Charading/SM65/(list of files, drawings)

Other design files:
testing/hall_matrix/freerouting.dsn
testing/hall_matrix/temp-freerouting.dsn
