Charading/SM65/pcbs/SM65.kicad_pcb

## KiCad design pcbs/SM65.kicad_pcb (2025-11-28)

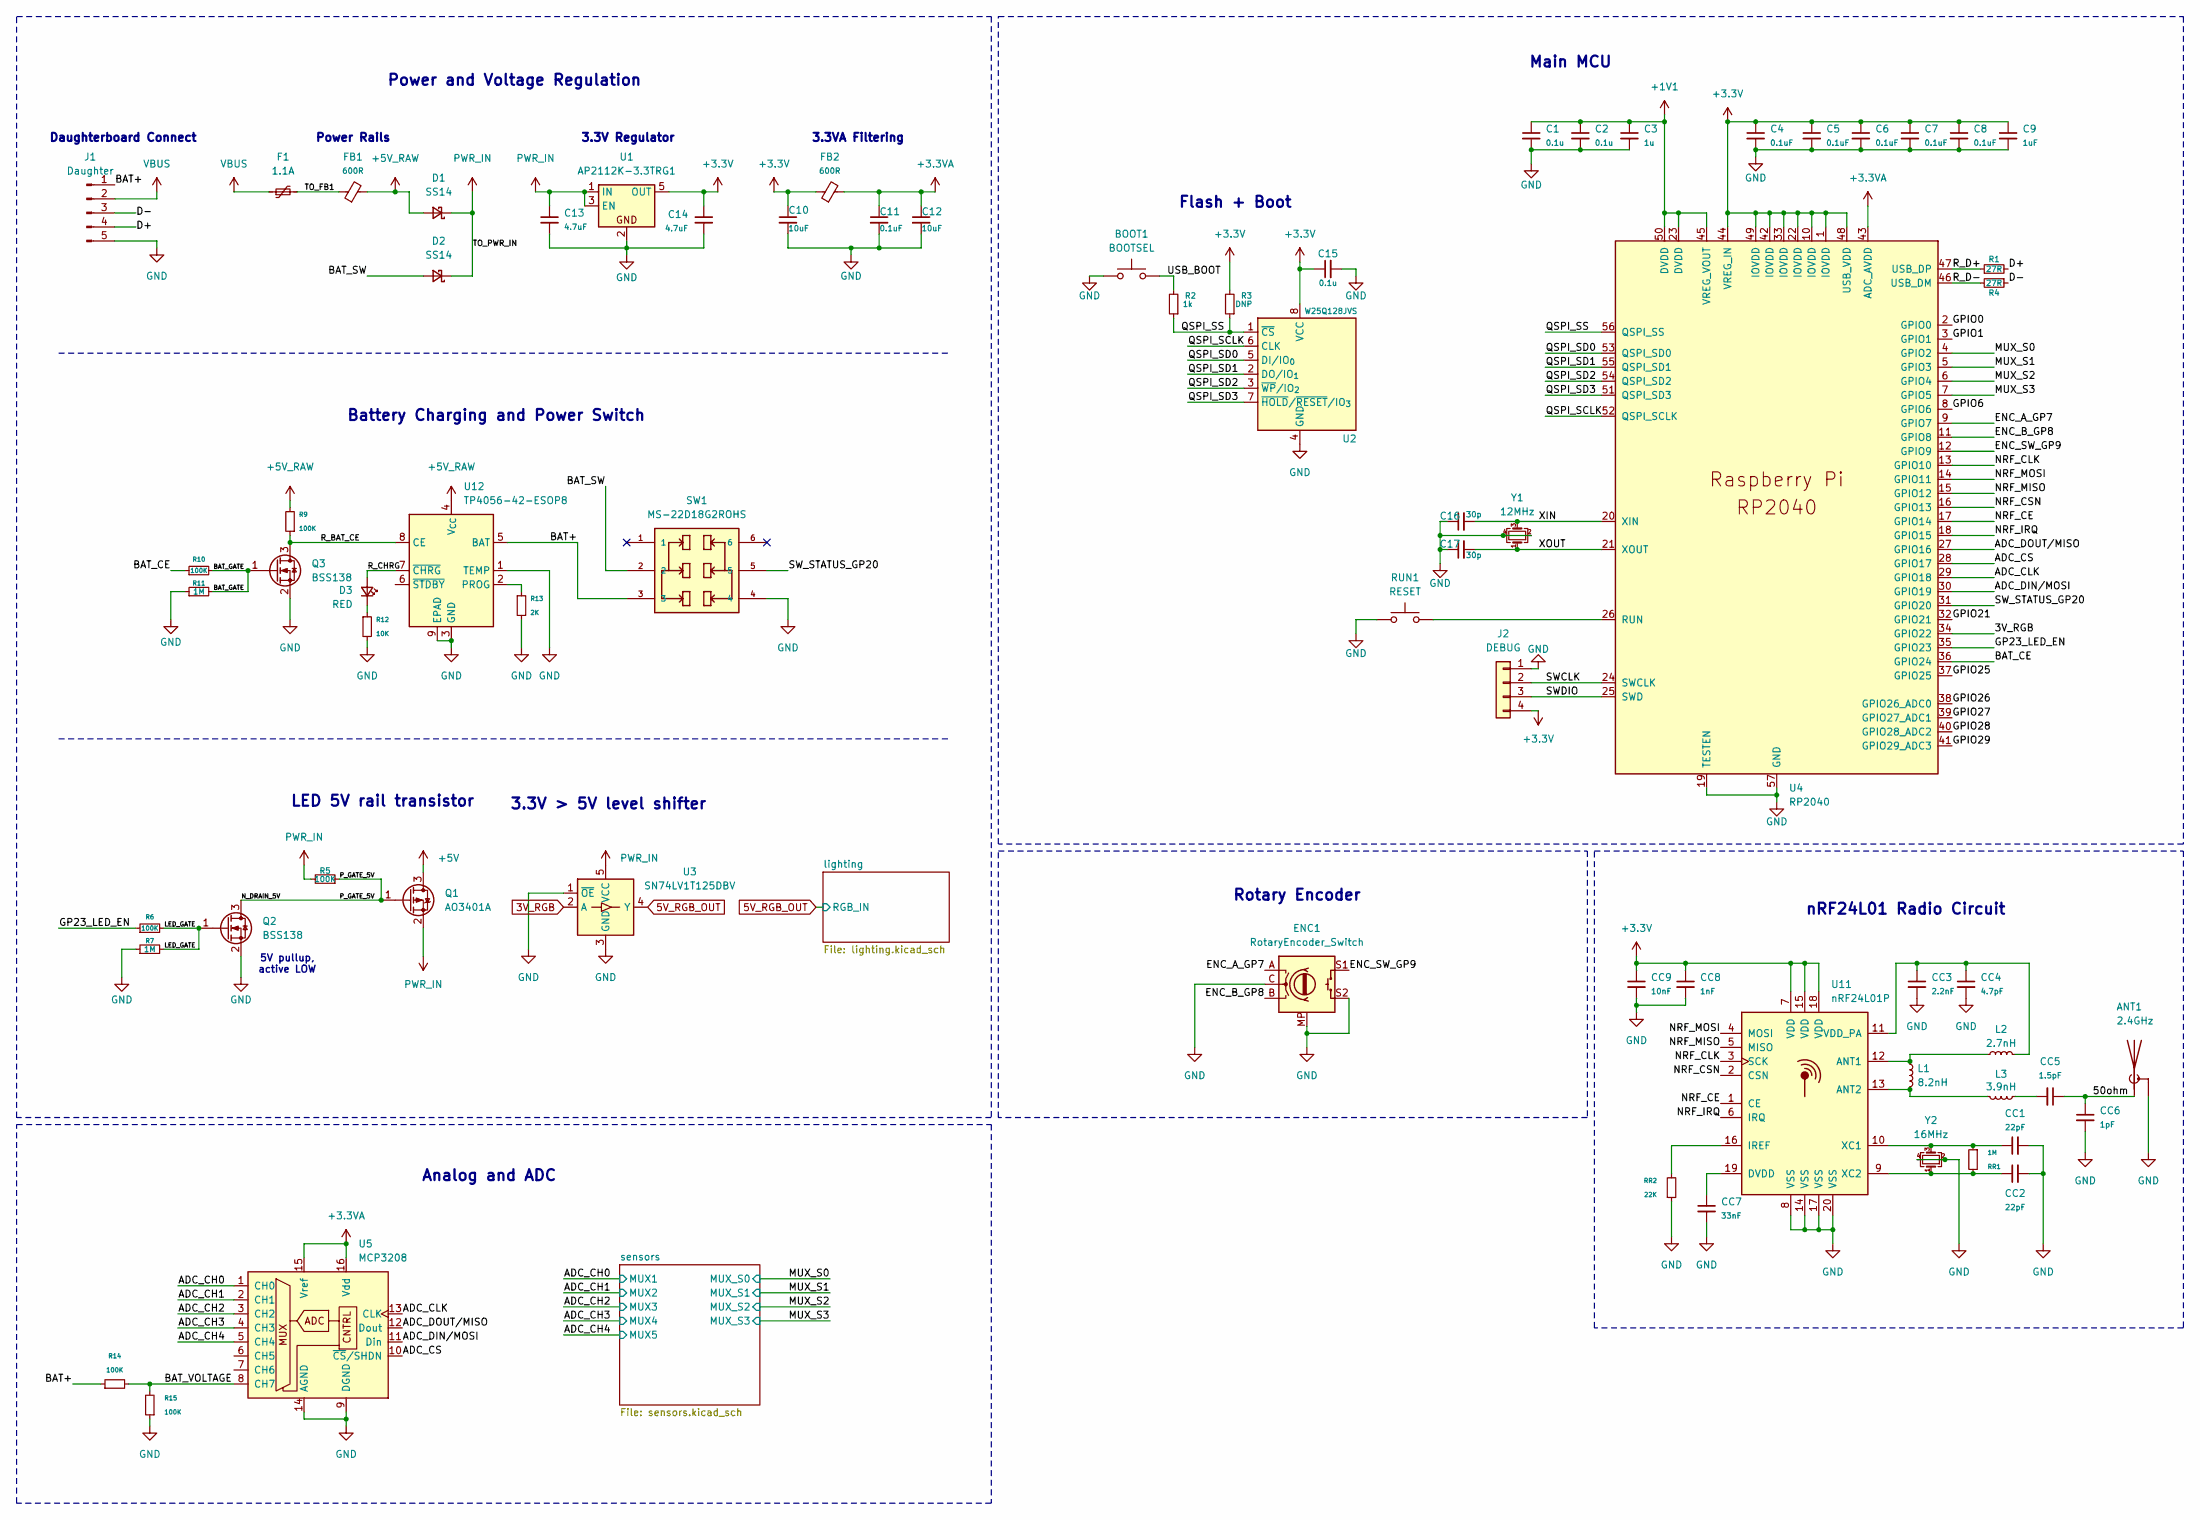
[picture p1: schematic SM65.kicad_sch]

Parts:
ANT1: 2.4GHz; MIFA_2.4GHz_Antenna
BOOT1: BOOTSEL; SW_SPST_EVQP2_MiddlePushTravel_H2.5mm
C1, C2: 0.1u; C_0402
C3: 1u; C_0402
C4, C5, C6, C7, C8: 0.1uF; C_0402
C9: 1uF; C_0402
C10, C12: 10uF; C_0603
C11: 0.1uF; C_0603
C13, C14: 4.7uF; C_0603
C15: 0.1u; C_0603
C16, C17: 30p; C_0402
CC1, CC2: 22pF; C_0402
CC3: 2.2nF; C_0402
CC4: 4.7pF; C_0402
CC5: 1.5pF; C_0402
CC6: 1pF; C_0402
CC7: 33nF; C_0402
CC8: 1nF; C_0402
CC9: 10nF; C_0402
D1, D2: SS14; D_SMA
D3: RED; LED_0402_1005Metric
ENC1: RotaryEncoder_Switch; RotaryEncoder_MX_EC11_CircularMountingHoles
F1: 1.1A; Fuse_0603_1608Metric
FB1, FB2: 600R; Ferrite_0603_1608Metric
J1: Daughter; JST_GH_BM05B-GHS-TBT_1x05-1MP_P1.25mm_Vertical
J2: DEBUG; PinHeader_1x04_P1.27mm_Vertical; Part Number 1-0401FBV0T
L1: 8.2nH; R_0402
L2: 2.7nH; R_0402
L3: 3.9nH; R_0402
Q1: AO3401A; SOT-23
Q2, Q3: BSS138; SOT-23
R1, R4: 27R; R_0603_1608Metric_Pad0.98x0.95mm_HandSolder
R2: 1k; R_0603
R3: DNP; R_0603
R5, R6, R9, R10, R14, R15: 100K; R_0603
R7, R11: 1M; R_0603
R12: 10K; R_0402
R13: 2K; R_0603
RR1: 1M; R_0402
RR2: 22K; R_0402
RUN1: RESET; SW_SPST_EVQP2_MiddlePushTravel_H2.5mm
SW1: MS-22D18G2ROHS; MS-22D18_SMD
U1: AP2112K-3.3TRG1; SOT-23-5
U2: W25Q128JVS; SOIC-8_5.3x5.3mm_P1.27mm
U3: SN74LV1T125DBV; SOT-23-5
U4: RP2040; QFN-56-1EP_7x7mm_P0.4mm_EP3.2x3.2mm
U5: MCP3208; SOIC-16_3.9x9.9mm_P1.27mm
U11: nRF24L01P; QFN-20-1EP_4x4mm_P0.5mm_EP2.5x2.5mm
U12: TP4056-42-ESOP8; SOIC-8-1EP_3.9x4.9mm_P1.27mm_EP2.41x3.3mm
Y1: 12MHz; Crystal_SMD_3225-4Pin_3.2x2.5mm
Y2: 16MHz; Crystal_SMD_3225-4Pin_3.2x2.5mm

Connections:
3V_RGB: U3.2 (A), U4.34 (GPIO22)
5V_RGB_OUT: U3.4 (Y); also elsewhere on the board
+1V1: C1.1, C2.1, C3.1, U4.23 (DVDD), U4.45 (VREG_VOUT), U4.50 (DVDD)
+3.3V: C4.1, C5.1, C6.1, C7.1, C8.1, C9.1, C10.1, C14.1, C15.1, CC8.1, CC9.1, FB2.1, J2.4, R3.2, U1.5 (OUT), U2.8 (VCC), U4.1 (IOVDD), U4.10 (IOVDD), U4.22 (IOVDD), U4.33 (IOVDD), U4.42 (IOVDD), U4.44 (VREG_IN), U4.48 (USB_VDD), U4.49 (IOVDD), U11.7 (VDD), U11.15 (VDD), U11.18 (VDD); also elsewhere on the board
+3.3VA: C11.1, C12.1, FB2.2, U4.43 (ADC_AVDD), U5.15 (Vref), U5.16 (Vdd)
+5V: Q1.3 (D); also elsewhere on the board
+5V_RAW: D1.2 (A), FB1.2, R9.2, U12.4 (V_{CC})
/50ohm: ANT1.1 (A), CC5.1, CC6.1
/ADC_CH0: U5.1 (CH0); also elsewhere on the board
/ADC_CH1: U5.2 (CH1); also elsewhere on the board
/ADC_CH2: U5.3 (CH2); also elsewhere on the board
/ADC_CH3: U5.4 (CH3); also elsewhere on the board
/ADC_CH4: U5.5 (CH4); also elsewhere on the board
/ADC_CLK: U4.29 (GPIO18), U5.13 (CLK)
/ADC_CS: U4.28 (GPIO17), U5.10 (~CS/SHDN)
/ADC_DIN/MOSI: U4.30 (GPIO19), U5.11 (Din)
/ADC_DOUT/MISO: U4.27 (GPIO16), U5.12 (Dout)
/BAT+: J1.1, R14.1, SW1.3, U12.5 (BAT)
/BAT_CE: R10.1, U4.36 (GPIO24)
/BAT_GATE: Q3.1 (G), R10.2, R11.2
/BAT_SW: D2.2 (A), SW1.2
/BAT_VOLTAGE: R14.2, R15.2, U5.8 (CH7)
/D+: J1.4, R1.2
/D-: J1.3, R4.1
/ENC_A_GP7: ENC1.A, U4.9 (GPIO7)
/ENC_B_GP8: ENC1.B, U4.11 (GPIO8)
/ENC_SW_GP9: ENC1.S1, U4.12 (GPIO9)
/GP23_LED_EN: R6.1, U4.35 (GPIO23)
/GPIO0: U4.2 (GPIO0)
/GPIO1: U4.3 (GPIO1)
/GPIO6: U4.8 (GPIO6)
/GPIO21: U4.32 (GPIO21)
/GPIO25: U4.37 (GPIO25)
/GPIO26: U4.38 (GPIO26_ADC0)
/GPIO27: U4.39 (GPIO27_ADC1)
/GPIO28: U4.40 (GPIO28_ADC2)
/GPIO29: U4.41 (GPIO29_ADC3)
/LED_GATE: Q2.1 (G), R6.2, R7.2
/MUX_S0: U4.4 (GPIO2); also elsewhere on the board
/MUX_S1: U4.5 (GPIO3); also elsewhere on the board
/MUX_S2: U4.6 (GPIO4); also elsewhere on the board
/MUX_S3: U4.7 (GPIO5); also elsewhere on the board
/NRF_CE: U4.17 (GPIO14), U11.1 (CE)
/NRF_CLK: U4.13 (GPIO10), U11.3 (SCK)
/NRF_CSN: U4.16 (GPIO13), U11.2 (CSN)
/NRF_IRQ: U4.18 (GPIO15), U11.6 (IRQ)
/NRF_MISO: U4.15 (GPIO12), U11.5 (MISO)
/NRF_MOSI: U4.14 (GPIO11), U11.4 (MOSI)
/N_DRAIN_5V: Q1.1 (G), Q2.3 (D), R5.1
/QSPI_SCLK: U2.6 (CLK), U4.52 (QSPI_SCLK)
/QSPI_SD0: U2.5 (DI/IO_{0}), U4.53 (QSPI_SD0)
/QSPI_SD1: U2.2 (DO/IO_{1}), U4.55 (QSPI_SD1)
/QSPI_SD2: U2.3 (~WP/IO_{2}), U4.54 (QSPI_SD2)
/QSPI_SD3: U2.7 (~HOLD/~RESET/IO_{3}), U4.51 (QSPI_SD3)
/QSPI_SS: R2.1, R3.1, U2.1 (~CS), U4.56 (QSPI_SS)
/R_BAT_CE: Q3.3 (D), R9.1, U12.8 (CE)
/R_CHRG: D3.2 (A), U12.7 (~CHRG)
/R_D+: R1.1, U4.47 (USB_DP)
/R_D-: R4.2, U4.46 (USB_DM)
/SWCLK: J2.2, U4.24 (SWCLK)
/SWDIO: J2.3, U4.25 (SWD)
/SW_STATUS_GP20: SW1.5, U4.31 (GPIO20)
/TO_FB1: F1.2, FB1.1
/USB_BOOT: BOOT1.2, R2.2
/XIN: C16.2, U4.20 (XIN), Y1.3
/XOUT: C17.2, U4.21 (XOUT), Y1.1
GND: ANT1.2 (Shield), BOOT1.1, C1.2, C2.2, C3.2, C4.2, C5.2, C6.2, C7.2, C8.2, C9.2, C10.2, C11.2, C12.2, C13.2, C14.2, C15.2, C16.1, C17.1, CC1.2, CC2.2, CC3.2, CC4.2, CC6.2, CC7.2, CC8.2, CC9.2, ENC1.C, ENC1.MP, ENC1.S2, J1.5, J2.1, Q2.2 (S), Q3.2 (S), R7.1, R11.1, R12.2, R13.2, R15.1, RR2.1, RUN1.1, SW1.4, U1.2, U2.4 (GND), U3.1 (~OE), U3.3 (GND), U4.19 (TESTEN), U4.57 (GND), U5.9 (DGND), U5.14 (AGND), U11.8 (VSS), U11.14 (VSS), U11.17 (VSS), U11.20 (VSS), U12.1 (TEMP), U12.3 (GND), U12.9 (EPAD), Y1.2, Y1.4, Y2.2, Y2.4; also elsewhere on the board
unnamed: CC5.2, L3.1
unnamed: D3.1 (K), R12.1
unnamed: RUN1.2, U4.26 (RUN)
unnamed: L1.1, L2.1, U11.12 (ANT1)
unnamed: L1.2, L3.2, U11.13 (ANT2)
unnamed: CC7.1, U11.19 (DVDD)
unnamed: RR2.2, U11.16 (IREF)
unnamed: CC3.1, CC4.1, L2.2, U11.11 (VDD_PA)
unnamed: CC1.1, RR1.1, U11.10 (XC1), Y2.3
unnamed: CC2.1, RR1.2, U11.9 (XC2), Y2.1
unnamed: R13.1, U12.2 (PROG)
PWR_IN: C13.1, D1.1 (K), D2.1 (K), Q1.2 (S), R5.2, U1.1 (IN), U1.3 (EN), U3.5 (VCC)
VBUS: F1.1, J1.2

Notes on the sheet:
LED 5V rail transistor
3.3V > 5V level shifter
Rotary Encoder
Flash + Boot
5V pullup, active LOW
Battery Charging and Power Switch
Daughterboard Connect
Analog and ADC
3.3V Regulator
nRF24L01 Radio Circuit
Power and Voltage Regulation
3.3VA Filtering
Main MCU
Power Rails

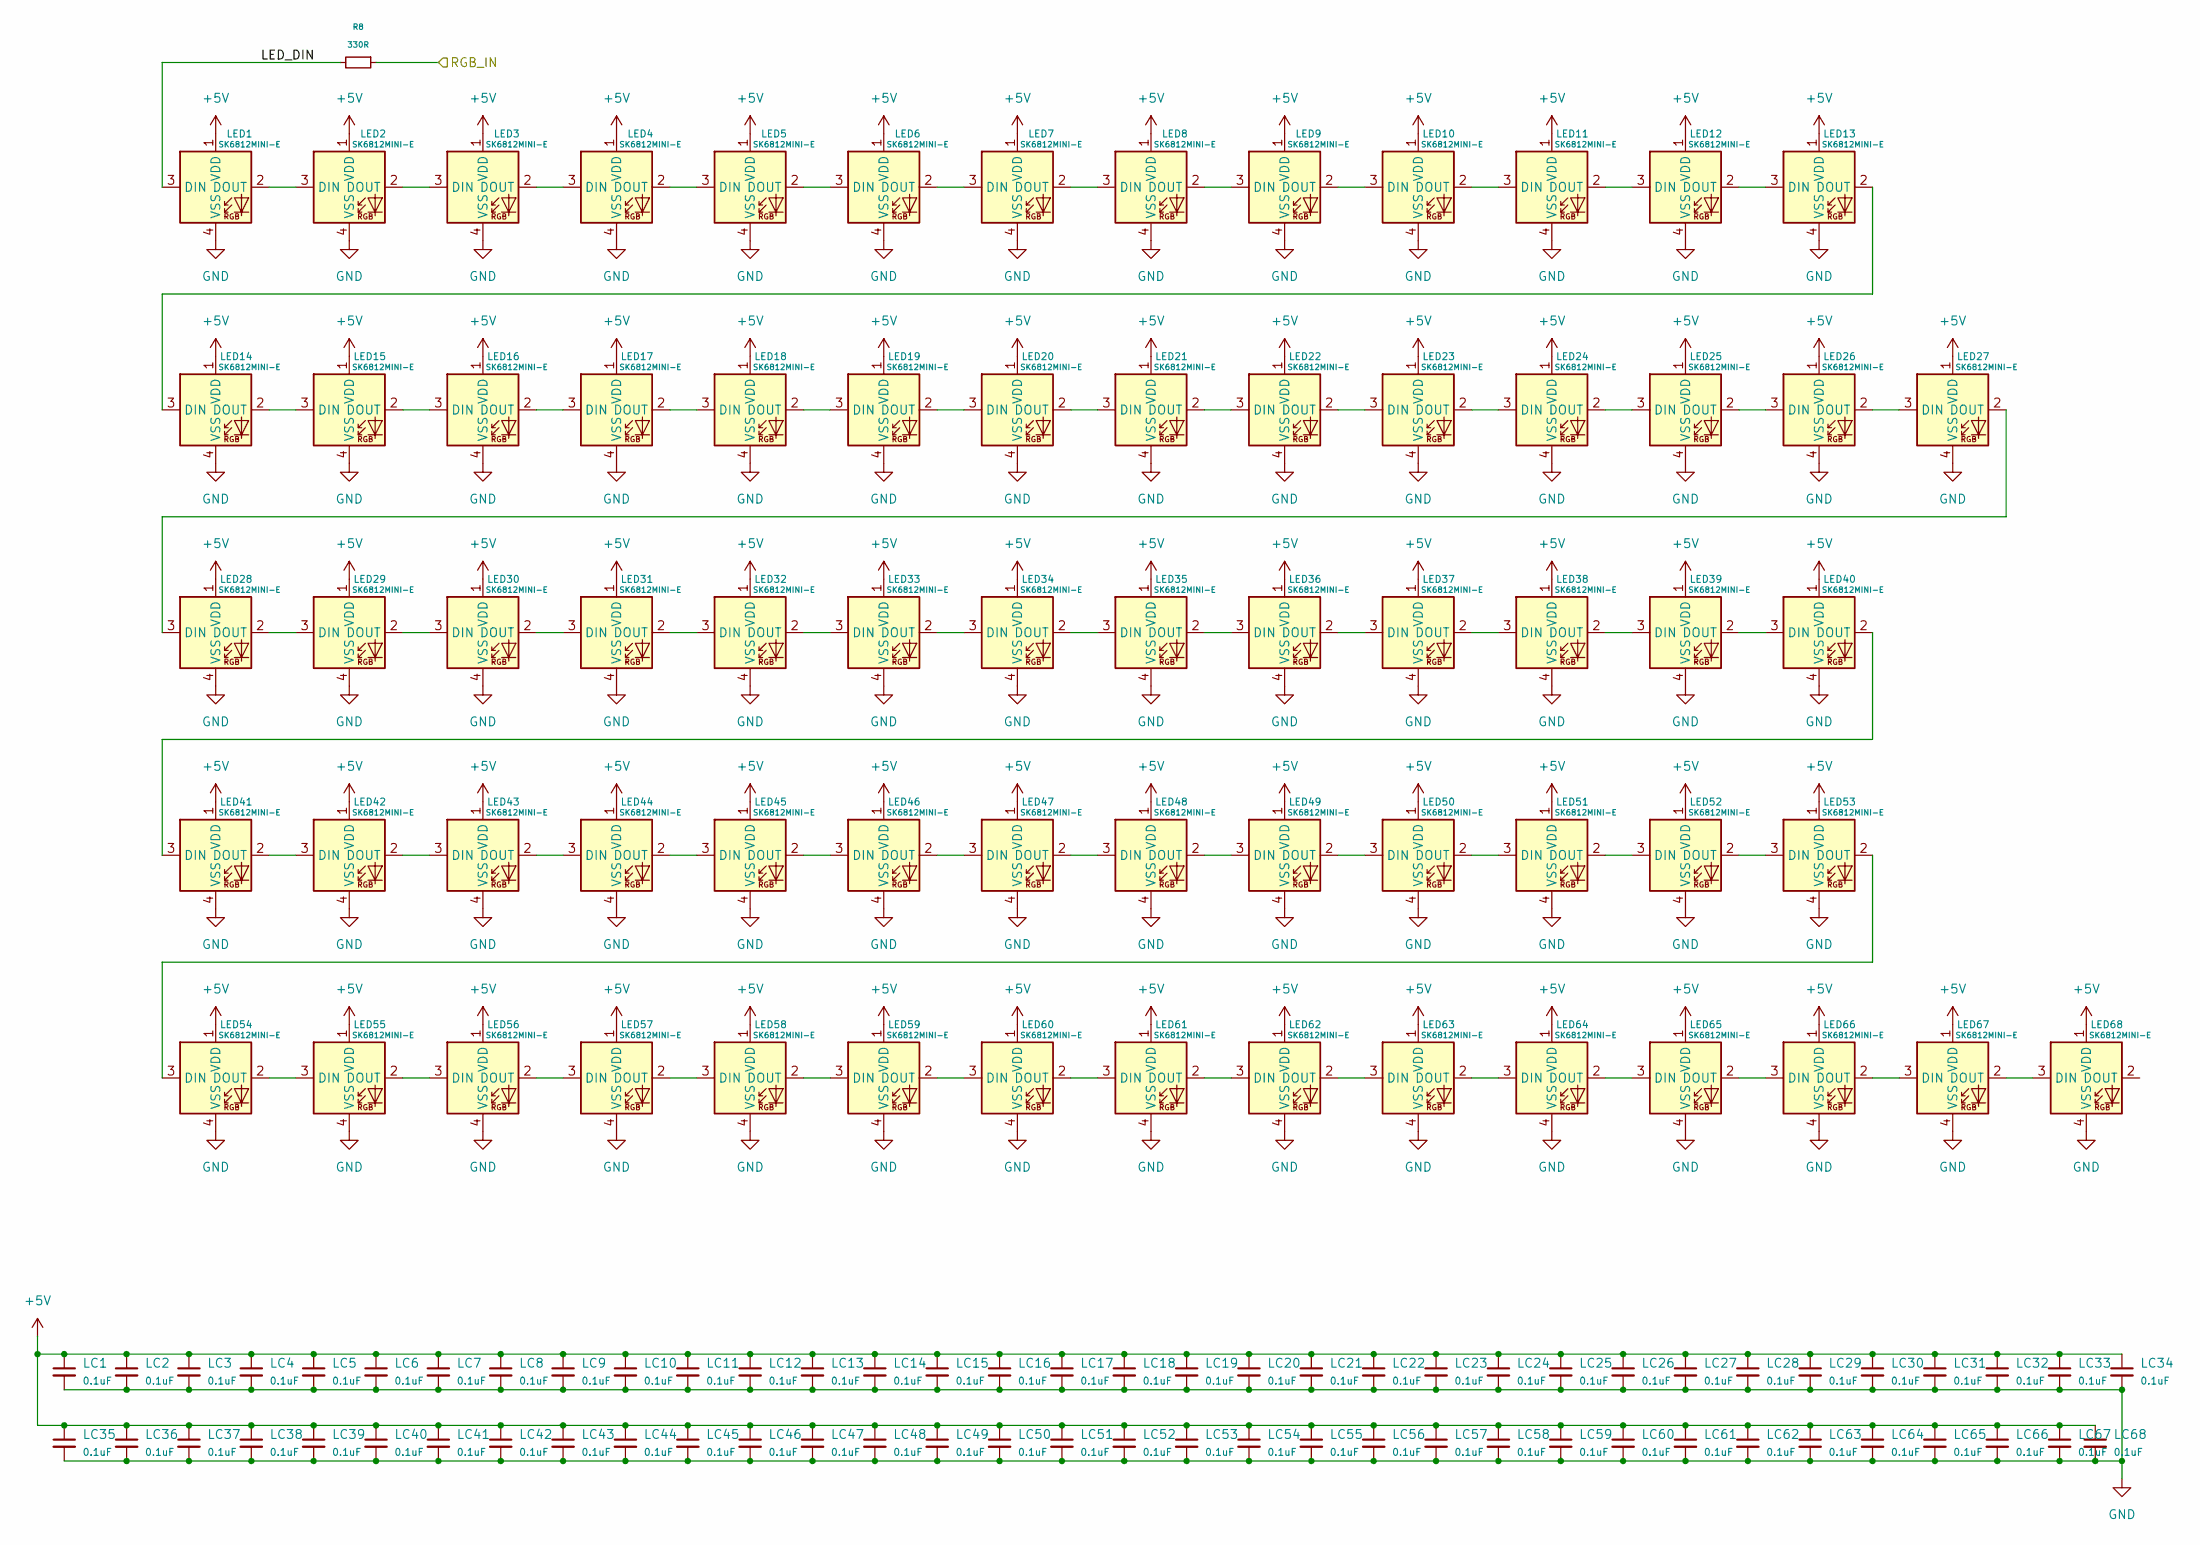
[picture p2: schematic lighting.kicad_sch]

Parts:
LC1, LC2, LC3, LC4, LC5, LC6, LC7, LC8, LC9, LC10, LC11, LC12, LC13, LC14, LC15, LC16, LC17, LC18, LC19, LC20, LC21, LC22, LC23, LC24, LC25, LC26, LC27, LC28, LC29, LC30, LC31, LC32, LC33, LC34, LC35, LC36, LC37, LC38, LC39, LC40, LC41, LC42, LC43, LC44, LC45, LC46, LC47, LC48, LC49, LC50, LC51, LC52, LC53, LC54, LC55, LC56, LC57, LC58, LC59, LC60, LC61, LC62, LC63, LC64, LC65, LC66, LC67, LC68: 0.1uF; C_0402
LED1, LED2, LED3, LED4, LED5, LED6, LED7, LED8, LED9, LED10, LED11, LED12, LED13, LED14, LED15, LED16, LED17, LED18, LED19, LED20, LED21, LED22, LED23, LED24, LED25, LED26, LED27, LED28, LED29, LED30, LED31, LED32, LED33, LED34, LED35, LED36, LED37, LED38, LED39, LED40, LED41, LED42, LED43, LED44, LED45, LED46, LED47, LED48, LED49, LED50, LED51, LED52, LED53, LED54, LED55, LED56, LED57, LED58, LED59, LED60, LED61, LED62, LED63, LED64, LED65, LED66, LED67, LED68: SK6812MINI-E; LED_6028R; LCSC C5149201
R8: 330R; R_0603

Connections:
5V_RGB_OUT: R8.1; also elsewhere on the board
+5V: LC1.1, LC2.1, LC3.1, LC4.1, LC5.1, LC6.1, LC7.1, LC8.1, LC9.1, LC10.1, LC11.1, LC12.1, LC13.1, LC14.1, LC15.1, LC16.1, LC17.1, LC18.1, LC19.1, LC20.1, LC21.1, LC22.1, LC23.1, LC24.1, LC25.1, LC26.1, LC27.1, LC28.1, LC29.1, LC30.1, LC31.1, LC32.1, LC33.1, LC34.1, LC35.1, LC36.1, LC37.1, LC38.1, LC39.1, LC40.1, LC41.1, LC42.1, LC43.1, LC44.1, LC45.1, LC46.1, LC47.1, LC48.1, LC49.1, LC50.1, LC51.1, LC52.1, LC53.1, LC54.1, LC55.1, LC56.1, LC57.1, LC58.1, LC59.1, LC60.1, LC61.1, LC62.1, LC63.1, LC64.1, LC65.1, LC66.1, LC67.1, LC68.1, LED1.1 (VDD), LED2.1 (VDD), LED3.1 (VDD), LED4.1 (VDD), LED5.1 (VDD), LED6.1 (VDD), LED7.1 (VDD), LED8.1 (VDD), LED9.1 (VDD), LED10.1 (VDD), LED11.1 (VDD), LED12.1 (VDD), LED13.1 (VDD), LED14.1 (VDD), LED15.1 (VDD), LED16.1 (VDD), LED17.1 (VDD), LED18.1 (VDD), LED19.1 (VDD), LED20.1 (VDD), LED21.1 (VDD), LED22.1 (VDD), LED23.1 (VDD), LED24.1 (VDD), LED25.1 (VDD), LED26.1 (VDD), LED27.1 (VDD), LED28.1 (VDD), LED29.1 (VDD), LED30.1 (VDD), LED31.1 (VDD), LED32.1 (VDD), LED33.1 (VDD), LED34.1 (VDD), LED35.1 (VDD), LED36.1 (VDD), LED37.1 (VDD), LED38.1 (VDD), LED39.1 (VDD), LED40.1 (VDD), LED41.1 (VDD), LED42.1 (VDD), LED43.1 (VDD), LED44.1 (VDD), LED45.1 (VDD), LED46.1 (VDD), LED47.1 (VDD), LED48.1 (VDD), LED49.1 (VDD), LED50.1 (VDD), LED51.1 (VDD), LED52.1 (VDD), LED53.1 (VDD), LED54.1 (VDD), LED55.1 (VDD), LED56.1 (VDD), LED57.1 (VDD), LED58.1 (VDD), LED59.1 (VDD), LED60.1 (VDD), LED61.1 (VDD), LED62.1 (VDD), LED63.1 (VDD), LED64.1 (VDD), LED65.1 (VDD), LED66.1 (VDD), LED67.1 (VDD), LED68.1 (VDD); also elsewhere on the board
/lighting/LED_DIN: LED1.3 (DIN), R8.2
GND: LC1.2, LC2.2, LC3.2, LC4.2, LC5.2, LC6.2, LC7.2, LC8.2, LC9.2, LC10.2, LC11.2, LC12.2, LC13.2, LC14.2, LC15.2, LC16.2, LC17.2, LC18.2, LC19.2, LC20.2, LC21.2, LC22.2, LC23.2, LC24.2, LC25.2, LC26.2, LC27.2, LC28.2, LC29.2, LC30.2, LC31.2, LC32.2, LC33.2, LC34.2, LC35.2, LC36.2, LC37.2, LC38.2, LC39.2, LC40.2, LC41.2, LC42.2, LC43.2, LC44.2, LC45.2, LC46.2, LC47.2, LC48.2, LC49.2, LC50.2, LC51.2, LC52.2, LC53.2, LC54.2, LC55.2, LC56.2, LC57.2, LC58.2, LC59.2, LC60.2, LC61.2, LC62.2, LC63.2, LC64.2, LC65.2, LC66.2, LC67.2, LC68.2, LED1.4 (VSS), LED2.4 (VSS), LED3.4 (VSS), LED4.4 (VSS), LED5.4 (VSS), LED6.4 (VSS), LED7.4 (VSS), LED8.4 (VSS), LED9.4 (VSS), LED10.4 (VSS), LED11.4 (VSS), LED12.4 (VSS), LED13.4 (VSS), LED14.4 (VSS), LED15.4 (VSS), LED16.4 (VSS), LED17.4 (VSS), LED18.4 (VSS), LED19.4 (VSS), LED20.4 (VSS), LED21.4 (VSS), LED22.4 (VSS), LED23.4 (VSS), LED24.4 (VSS), LED25.4 (VSS), LED26.4 (VSS), LED27.4 (VSS), LED28.4 (VSS), LED29.4 (VSS), LED30.4 (VSS), LED31.4 (VSS), LED32.4 (VSS), LED33.4 (VSS), LED34.4 (VSS), LED35.4 (VSS), LED36.4 (VSS), LED37.4 (VSS), LED38.4 (VSS), LED39.4 (VSS), LED40.4 (VSS), LED41.4 (VSS), LED42.4 (VSS), LED43.4 (VSS), LED44.4 (VSS), LED45.4 (VSS), LED46.4 (VSS), LED47.4 (VSS), LED48.4 (VSS), LED49.4 (VSS), LED50.4 (VSS), LED51.4 (VSS), LED52.4 (VSS), LED53.4 (VSS), LED54.4 (VSS), LED55.4 (VSS), LED56.4 (VSS), LED57.4 (VSS), LED58.4 (VSS), LED59.4 (VSS), LED60.4 (VSS), LED61.4 (VSS), LED62.4 (VSS), LED63.4 (VSS), LED64.4 (VSS), LED65.4 (VSS), LED66.4 (VSS), LED67.4 (VSS), LED68.4 (VSS); also elsewhere on the board
unnamed: LED1.2 (DOUT), LED2.3 (DIN)
unnamed: LED2.2 (DOUT), LED3.3 (DIN)
unnamed: LED3.2 (DOUT), LED4.3 (DIN)
unnamed: LED4.2 (DOUT), LED5.3 (DIN)
unnamed: LED5.2 (DOUT), LED6.3 (DIN)
unnamed: LED6.2 (DOUT), LED7.3 (DIN)
unnamed: LED7.2 (DOUT), LED8.3 (DIN)
unnamed: LED8.2 (DOUT), LED9.3 (DIN)
unnamed: LED9.2 (DOUT), LED10.3 (DIN)
unnamed: LED10.2 (DOUT), LED11.3 (DIN)
unnamed: LED11.2 (DOUT), LED12.3 (DIN)
unnamed: LED12.2 (DOUT), LED13.3 (DIN)
unnamed: LED13.2 (DOUT), LED14.3 (DIN)
unnamed: LED14.2 (DOUT), LED15.3 (DIN)
unnamed: LED15.2 (DOUT), LED16.3 (DIN)
unnamed: LED16.2 (DOUT), LED17.3 (DIN)
unnamed: LED17.2 (DOUT), LED18.3 (DIN)
unnamed: LED18.2 (DOUT), LED19.3 (DIN)
unnamed: LED19.2 (DOUT), LED20.3 (DIN)
unnamed: LED20.2 (DOUT), LED21.3 (DIN)
unnamed: LED21.2 (DOUT), LED22.3 (DIN)
unnamed: LED22.2 (DOUT), LED23.3 (DIN)
unnamed: LED23.2 (DOUT), LED24.3 (DIN)
unnamed: LED24.2 (DOUT), LED25.3 (DIN)
unnamed: LED25.2 (DOUT), LED26.3 (DIN)
unnamed: LED26.2 (DOUT), LED27.3 (DIN)
unnamed: LED27.2 (DOUT), LED28.3 (DIN)
unnamed: LED28.2 (DOUT), LED29.3 (DIN)
unnamed: LED29.2 (DOUT), LED30.3 (DIN)
unnamed: LED30.2 (DOUT), LED31.3 (DIN)
unnamed: LED31.2 (DOUT), LED32.3 (DIN)
unnamed: LED32.2 (DOUT), LED33.3 (DIN)
unnamed: LED33.2 (DOUT), LED34.3 (DIN)
unnamed: LED34.2 (DOUT), LED35.3 (DIN)
unnamed: LED35.2 (DOUT), LED36.3 (DIN)
unnamed: LED36.2 (DOUT), LED37.3 (DIN)
unnamed: LED37.2 (DOUT), LED38.3 (DIN)
unnamed: LED38.2 (DOUT), LED39.3 (DIN)
unnamed: LED39.2 (DOUT), LED40.3 (DIN)
unnamed: LED40.2 (DOUT), LED41.3 (DIN)
unnamed: LED41.2 (DOUT), LED42.3 (DIN)
unnamed: LED42.2 (DOUT), LED43.3 (DIN)
unnamed: LED43.2 (DOUT), LED44.3 (DIN)
unnamed: LED44.2 (DOUT), LED45.3 (DIN)
unnamed: LED45.2 (DOUT), LED46.3 (DIN)
unnamed: LED46.2 (DOUT), LED47.3 (DIN)
unnamed: LED47.2 (DOUT), LED48.3 (DIN)
unnamed: LED48.2 (DOUT), LED49.3 (DIN)
unnamed: LED49.2 (DOUT), LED50.3 (DIN)
unnamed: LED50.2 (DOUT), LED51.3 (DIN)
unnamed: LED51.2 (DOUT), LED52.3 (DIN)
unnamed: LED52.2 (DOUT), LED53.3 (DIN)
unnamed: LED53.2 (DOUT), LED54.3 (DIN)
unnamed: LED54.2 (DOUT), LED55.3 (DIN)
unnamed: LED55.2 (DOUT), LED56.3 (DIN)
unnamed: LED56.2 (DOUT), LED57.3 (DIN)
unnamed: LED57.2 (DOUT), LED58.3 (DIN)
unnamed: LED58.2 (DOUT), LED59.3 (DIN)
unnamed: LED59.2 (DOUT), LED60.3 (DIN)
unnamed: LED60.2 (DOUT), LED61.3 (DIN)
unnamed: LED61.2 (DOUT), LED62.3 (DIN)
unnamed: LED62.2 (DOUT), LED63.3 (DIN)
unnamed: LED63.2 (DOUT), LED64.3 (DIN)
unnamed: LED64.2 (DOUT), LED65.3 (DIN)
unnamed: LED65.2 (DOUT), LED66.3 (DIN)
unnamed: LED66.2 (DOUT), LED67.3 (DIN)
unnamed: LED67.2 (DOUT), LED68.3 (DIN)

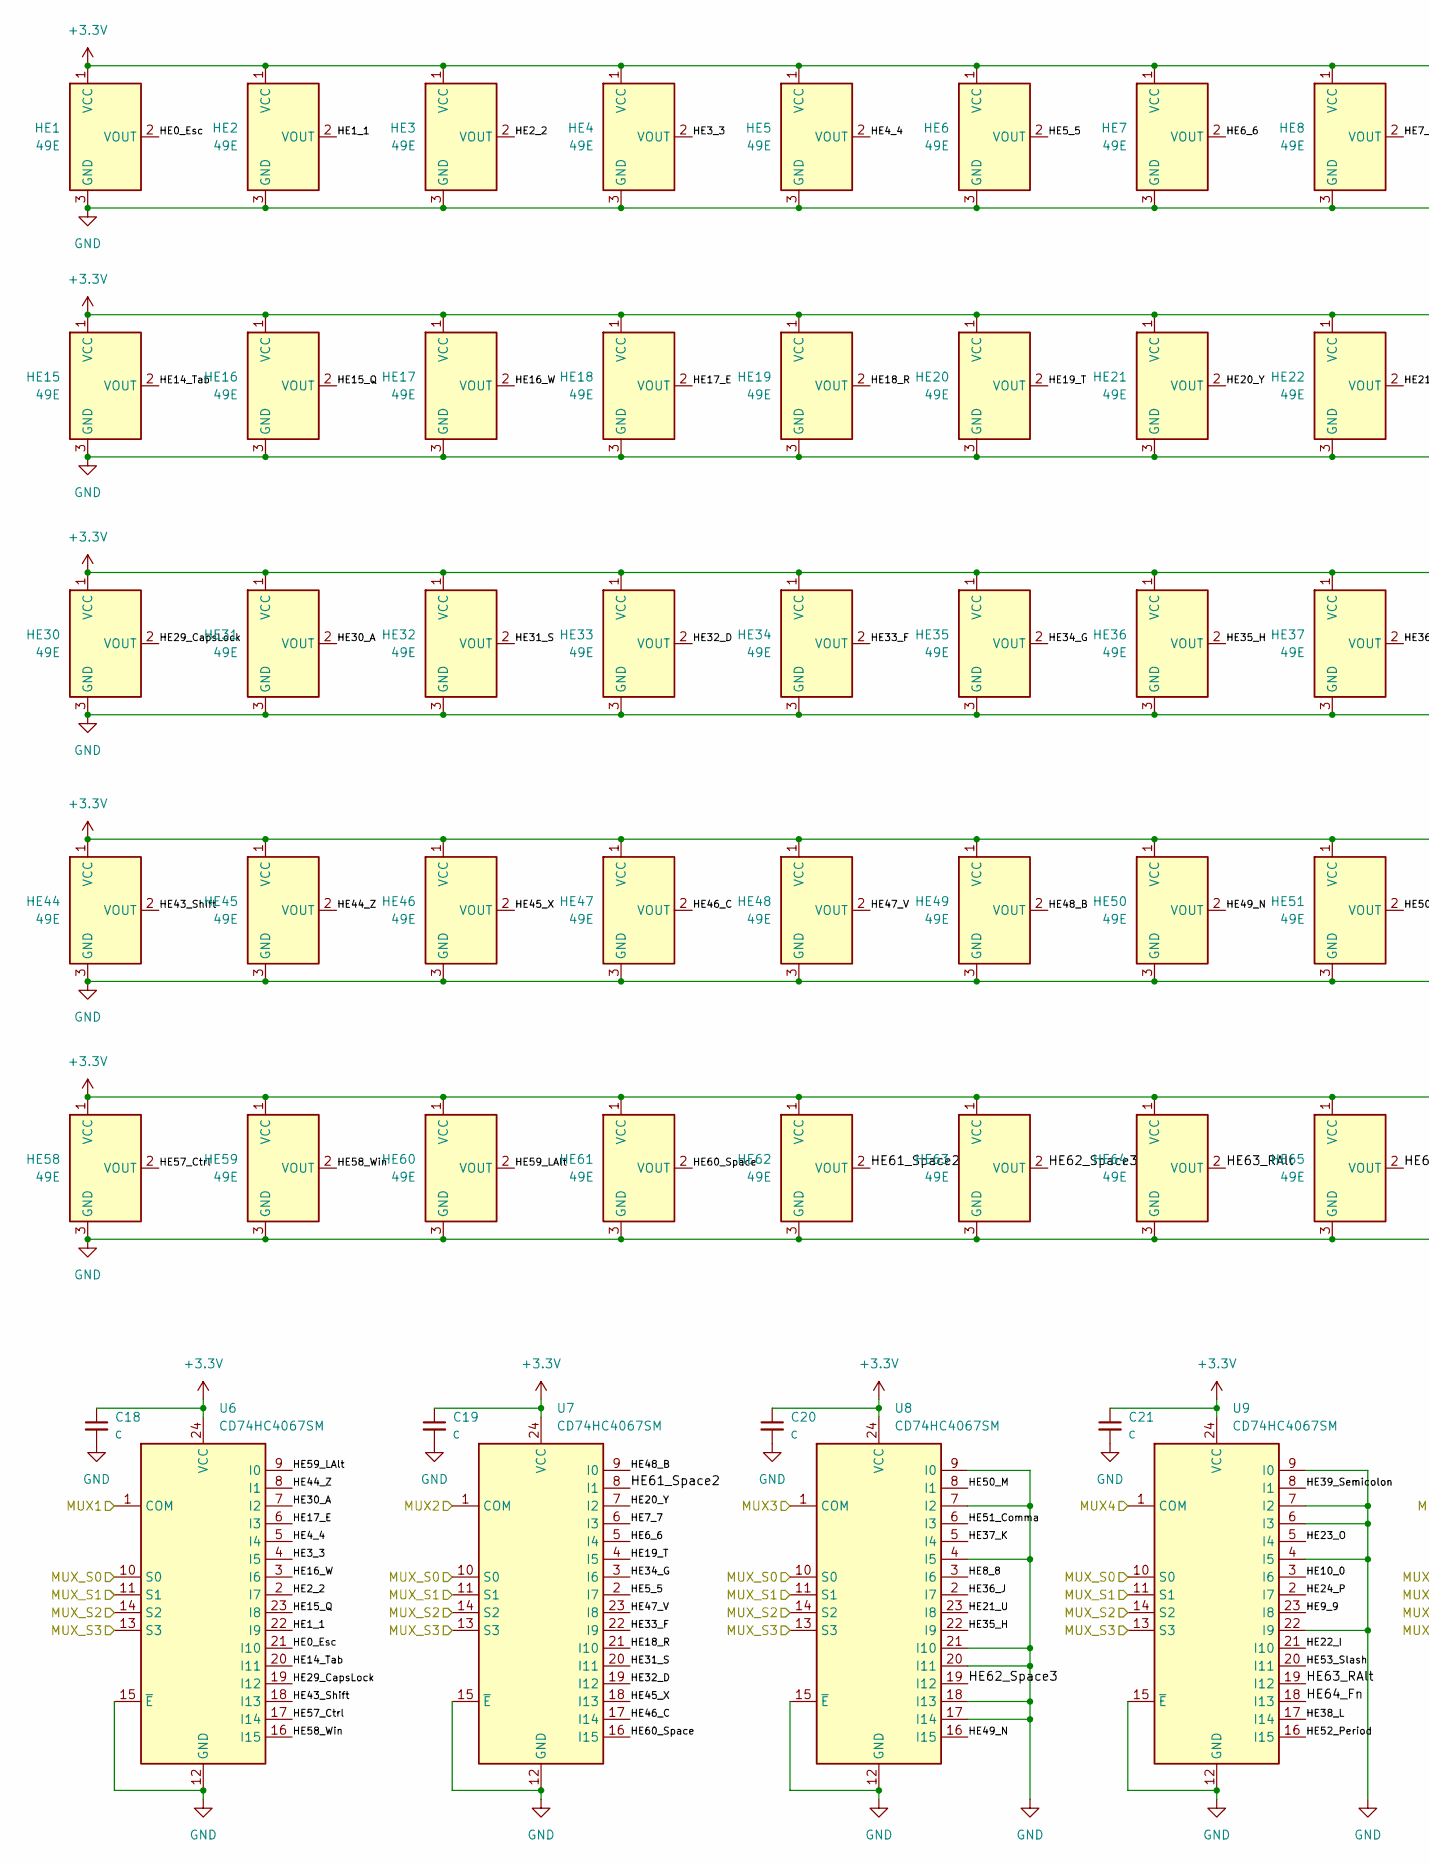
[picture p3: schematic sensors.kicad_sch, part in row 1, column 1]

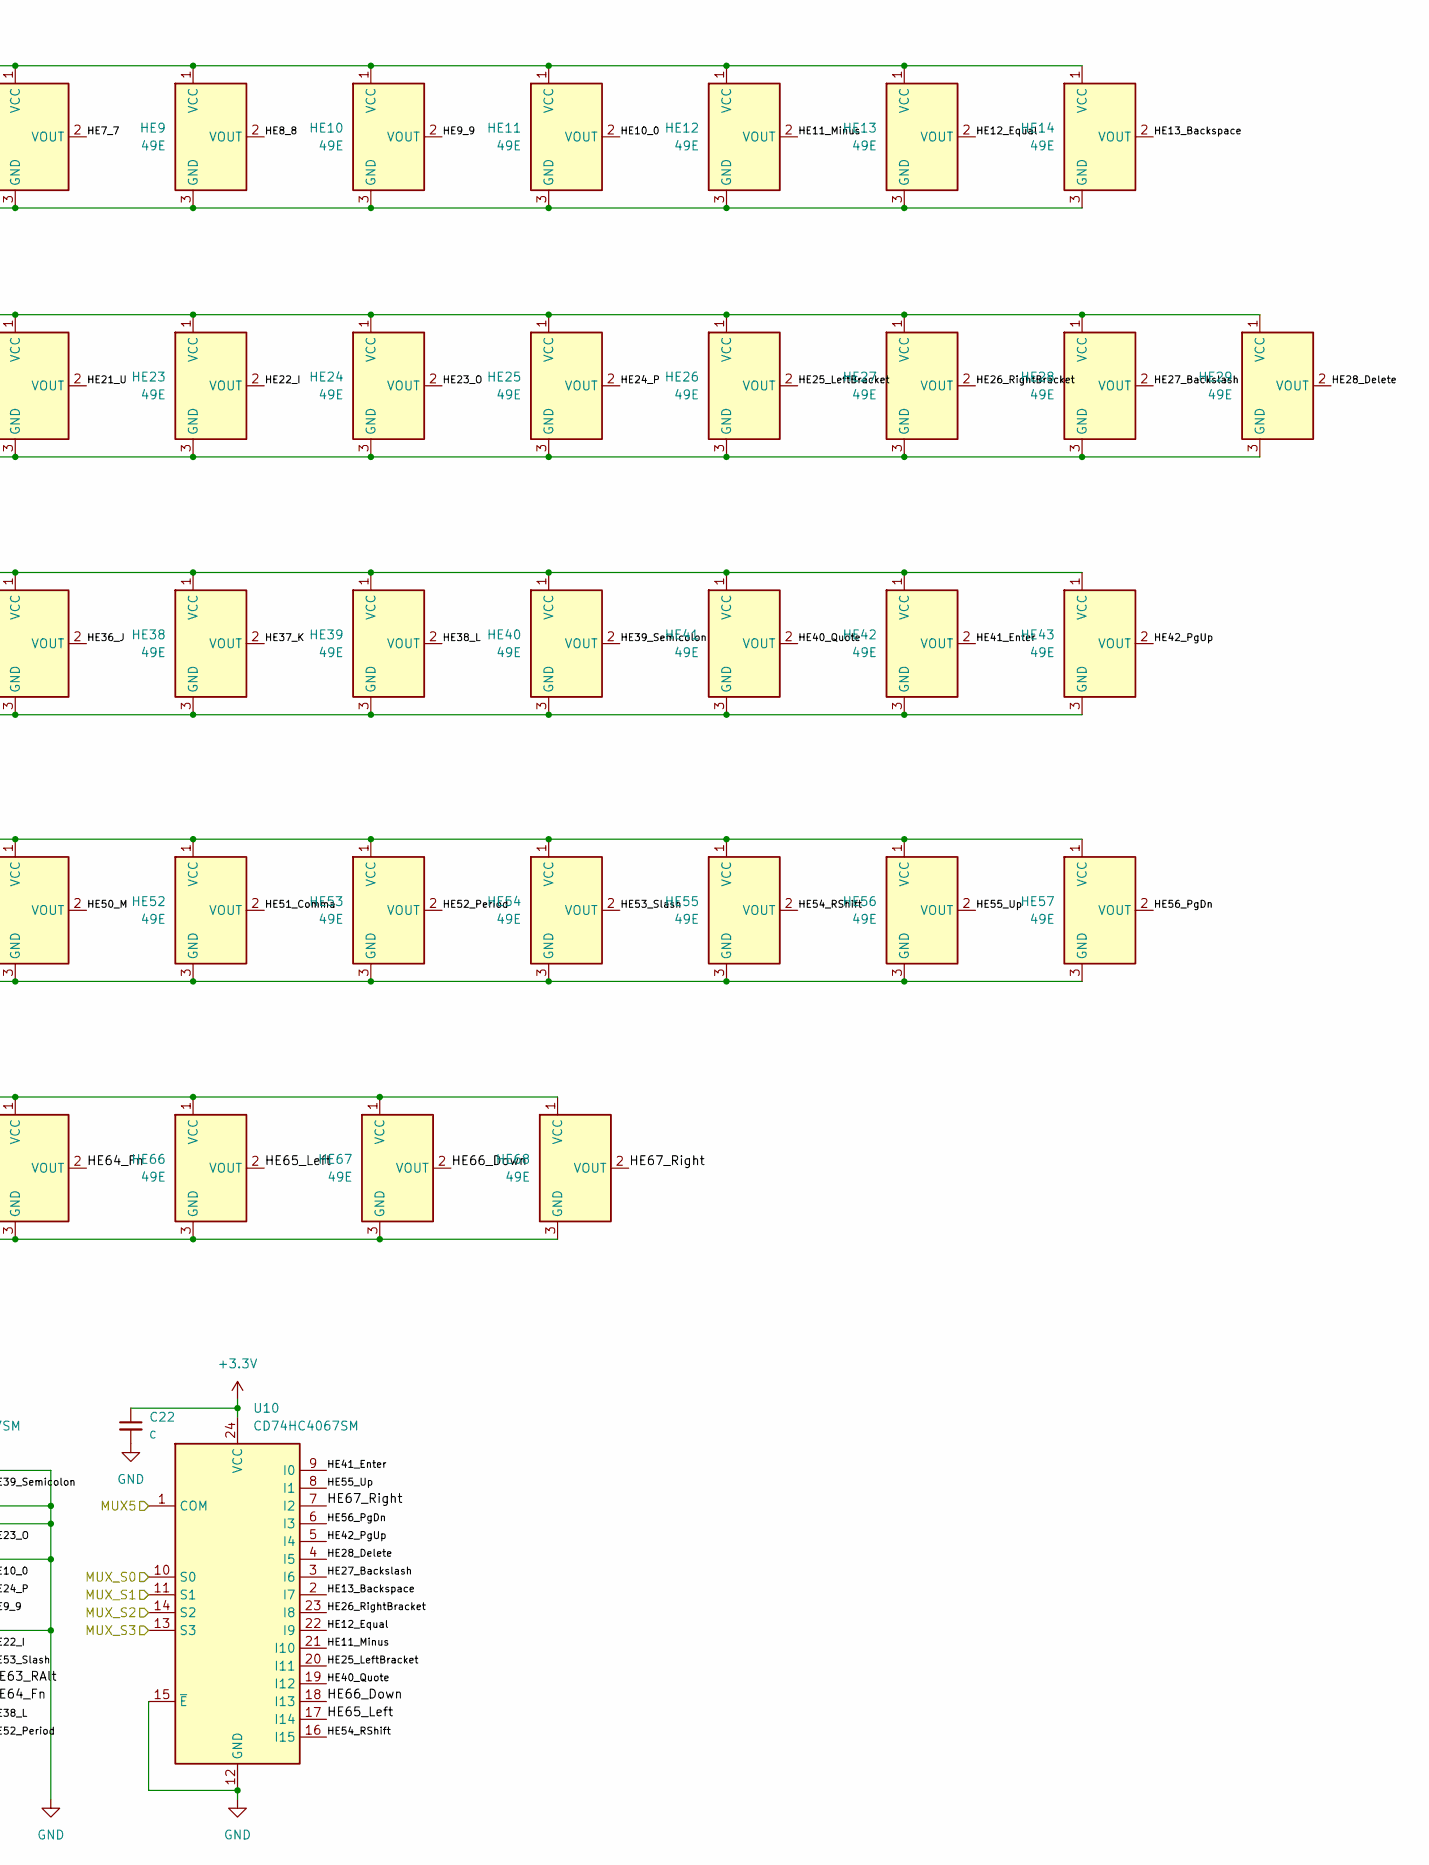
[picture p4: schematic sensors.kicad_sch, part in row 1, column 2]

Parts:
C18, C19, C20, C21, C22: C; C_0402
HE1, HE2, HE3, HE4, HE5, HE6, HE7, HE8, HE9, HE10, HE11, HE12, HE13, HE16, HE17, HE18, HE19, HE20, HE21, HE22, HE23, HE24, HE25, HE26, HE27, HE29, HE31, HE32, HE33, HE34, HE35, HE36, HE37, HE38, HE39, HE40, HE41, HE43, HE45, HE46, HE47, HE48, HE49, HE50, HE51, HE52, HE53, HE54, HE55, HE56, HE57, HE66, HE67, HE68: 49E; SW_MX_HE_90deg_1u_Rules; LCSC C7420984
HE14: 49E; SW_MX_HE_90deg_2.00u_Rules; LCSC C7420984
HE15, HE28: 49E; SW_MX_HE_90deg_1.5u_Rules; LCSC C7420984
HE30: 49E; SW_MX_HE_90deg_1.75u_Rules; LCSC C7420984
HE42, HE44, HE61: 49E; SW_MX_HE_90deg_2.25u_Rules; LCSC C7420984
HE58, HE59, HE60, HE62, HE64, HE65: 49E; SW_MX_HE_90deg_1.25u_Rules; LCSC C7420984
HE63: 49E; SW_MX_HE_90deg_2.75u_Rules; LCSC C7420984
U6, U7, U8, U9, U10: CD74HC4067SM; SSOP-24_5.3x8.2mm_P0.65mm

Connections:
+3.3V: C18.1, C19.1, C20.1, C21.1, C22.1, HE1.1 (VCC), HE2.1 (VCC), HE3.1 (VCC), HE4.1 (VCC), HE5.1 (VCC), HE6.1 (VCC), HE7.1 (VCC), HE8.1 (VCC), HE9.1 (VCC), HE10.1 (VCC), HE11.1 (VCC), HE12.1 (VCC), HE13.1 (VCC), HE14.1 (VCC), HE15.1 (VCC), HE16.1 (VCC), HE17.1 (VCC), HE18.1 (VCC), HE19.1 (VCC), HE20.1 (VCC), HE21.1 (VCC), HE22.1 (VCC), HE23.1 (VCC), HE24.1 (VCC), HE25.1 (VCC), HE26.1 (VCC), HE27.1 (VCC), HE28.1 (VCC), HE29.1 (VCC), HE30.1 (VCC), HE31.1 (VCC), HE32.1 (VCC), HE33.1 (VCC), HE34.1 (VCC), HE35.1 (VCC), HE36.1 (VCC), HE37.1 (VCC), HE38.1 (VCC), HE39.1 (VCC), HE40.1 (VCC), HE41.1 (VCC), HE42.1 (VCC), HE43.1 (VCC), HE44.1 (VCC), HE45.1 (VCC), HE46.1 (VCC), HE47.1 (VCC), HE48.1 (VCC), HE49.1 (VCC), HE50.1 (VCC), HE51.1 (VCC), HE52.1 (VCC), HE53.1 (VCC), HE54.1 (VCC), HE55.1 (VCC), HE56.1 (VCC), HE57.1 (VCC), HE58.1 (VCC), HE59.1 (VCC), HE60.1 (VCC), HE61.1 (VCC), HE62.1 (VCC), HE63.1 (VCC), HE64.1 (VCC), HE65.1 (VCC), HE66.1 (VCC), HE67.1 (VCC), HE68.1 (VCC), U6.24 (VCC), U7.24 (VCC), U8.24 (VCC), U9.24 (VCC), U10.24 (VCC); also elsewhere on the board
/ADC_CH0: U6.1 (COM); also elsewhere on the board
/ADC_CH1: U7.1 (COM); also elsewhere on the board
/ADC_CH2: U8.1 (COM); also elsewhere on the board
/ADC_CH3: U9.1 (COM); also elsewhere on the board
/ADC_CH4: U10.1 (COM); also elsewhere on the board
/MUX_S0: U6.10 (S0), U7.10 (S0), U8.10 (S0), U9.10 (S0), U10.10 (S0); also elsewhere on the board
/MUX_S1: U6.11 (S1), U7.11 (S1), U8.11 (S1), U9.11 (S1), U10.11 (S1); also elsewhere on the board
/MUX_S2: U6.14 (S2), U7.14 (S2), U8.14 (S2), U9.14 (S2), U10.14 (S2); also elsewhere on the board
/MUX_S3: U6.13 (S3), U7.13 (S3), U8.13 (S3), U9.13 (S3), U10.13 (S3); also elsewhere on the board
/sensors/HE0_Esc: HE1.2 (VOUT), U6.21 (I10)
/sensors/HE1_1: HE2.2 (VOUT), U6.22 (I9)
/sensors/HE2_2: HE3.2 (VOUT), U6.2 (I7)
/sensors/HE3_3: HE4.2 (VOUT), U6.4 (I5)
/sensors/HE4_4: HE5.2 (VOUT), U6.5 (I4)
/sensors/HE5_5: HE6.2 (VOUT), U7.2 (I7)
/sensors/HE6_6: HE7.2 (VOUT), U7.5 (I4)
/sensors/HE7_7: HE8.2 (VOUT), U7.6 (I3)
/sensors/HE8_8: HE9.2 (VOUT), U8.3 (I6)
/sensors/HE9_9: HE10.2 (VOUT), U9.23 (I8)
/sensors/HE10_0: HE11.2 (VOUT), U9.3 (I6)
/sensors/HE11_Minus: HE12.2 (VOUT), U10.21 (I10)
/sensors/HE12_Equal: HE13.2 (VOUT), U10.22 (I9)
/sensors/HE13_Backspace: HE14.2 (VOUT), U10.2 (I7)
/sensors/HE14_Tab: HE15.2 (VOUT), U6.20 (I11)
/sensors/HE15_Q: HE16.2 (VOUT), U6.23 (I8)
/sensors/HE16_W: HE17.2 (VOUT), U6.3 (I6)
/sensors/HE17_E: HE18.2 (VOUT), U6.6 (I3)
/sensors/HE18_R: HE19.2 (VOUT), U7.21 (I10)
/sensors/HE19_T: HE20.2 (VOUT), U7.4 (I5)
/sensors/HE20_Y: HE21.2 (VOUT), U7.7 (I2)
/sensors/HE21_U: HE22.2 (VOUT), U8.23 (I8)
/sensors/HE22_I: HE23.2 (VOUT), U9.21 (I10)
/sensors/HE23_O: HE24.2 (VOUT), U9.5 (I4)
/sensors/HE24_P: HE25.2 (VOUT), U9.2 (I7)
/sensors/HE25_LeftBracket: HE26.2 (VOUT), U10.20 (I11)
/sensors/HE26_RightBracket: HE27.2 (VOUT), U10.23 (I8)
/sensors/HE27_Backslash: HE28.2 (VOUT), U10.3 (I6)
/sensors/HE28_Delete: HE29.2 (VOUT), U10.4 (I5)
/sensors/HE29_CapsLock: HE30.2 (VOUT), U6.19 (I12)
/sensors/HE30_A: HE31.2 (VOUT), U6.7 (I2)
/sensors/HE31_S: HE32.2 (VOUT), U7.20 (I11)
/sensors/HE32_D: HE33.2 (VOUT), U7.19 (I12)
/sensors/HE33_F: HE34.2 (VOUT), U7.22 (I9)
/sensors/HE34_G: HE35.2 (VOUT), U7.3 (I6)
/sensors/HE35_H: HE36.2 (VOUT), U8.22 (I9)
/sensors/HE36_J: HE37.2 (VOUT), U8.2 (I7)
/sensors/HE37_K: HE38.2 (VOUT), U8.5 (I4)
/sensors/HE38_L: HE39.2 (VOUT), U9.17 (I14)
/sensors/HE39_Semicolon: HE40.2 (VOUT), U9.8 (I1)
/sensors/HE40_Quote: HE41.2 (VOUT), U10.19 (I12)
/sensors/HE41_Enter: HE42.2 (VOUT), U10.9 (I0)
/sensors/HE42_PgUp: HE43.2 (VOUT), U10.5 (I4)
/sensors/HE43_Shift: HE44.2 (VOUT), U6.18 (I13)
/sensors/HE44_Z: HE45.2 (VOUT), U6.8 (I1)
/sensors/HE45_X: HE46.2 (VOUT), U7.18 (I13)
/sensors/HE46_C: HE47.2 (VOUT), U7.17 (I14)
/sensors/HE47_V: HE48.2 (VOUT), U7.23 (I8)
/sensors/HE48_B: HE49.2 (VOUT), U7.9 (I0)
/sensors/HE49_N: HE50.2 (VOUT), U8.16 (I15)
/sensors/HE50_M: HE51.2 (VOUT), U8.8 (I1)
/sensors/HE51_Comma: HE52.2 (VOUT), U8.6 (I3)
/sensors/HE52_Period: HE53.2 (VOUT), U9.16 (I15)
/sensors/HE53_Slash: HE54.2 (VOUT), U9.20 (I11)
/sensors/HE54_RShift: HE55.2 (VOUT), U10.16 (I15)
/sensors/HE55_Up: HE56.2 (VOUT), U10.8 (I1)
/sensors/HE56_PgDn: HE57.2 (VOUT), U10.6 (I3)
/sensors/HE57_Ctrl: HE58.2 (VOUT), U6.17 (I14)
/sensors/HE58_Win: HE59.2 (VOUT), U6.16 (I15)
/sensors/HE59_LAlt: HE60.2 (VOUT), U6.9 (I0)
/sensors/HE60_Space: HE61.2 (VOUT), U7.16 (I15)
/sensors/HE61_Space2: HE62.2 (VOUT), U7.8 (I1)
/sensors/HE62_Space3: HE63.2 (VOUT), U8.19 (I12)
/sensors/HE63_RAlt: HE64.2 (VOUT), U9.19 (I12)
/sensors/HE64_Fn: HE65.2 (VOUT), U9.18 (I13)
/sensors/HE65_Left: HE66.2 (VOUT), U10.17 (I14)
/sensors/HE66_Down: HE67.2 (VOUT), U10.18 (I13)
/sensors/HE67_Right: HE68.2 (VOUT), U10.7 (I2)
GND: C18.2, C19.2, C20.2, C21.2, C22.2, HE1.3 (GND), HE2.3 (GND), HE3.3 (GND), HE4.3 (GND), HE5.3 (GND), HE6.3 (GND), HE7.3 (GND), HE8.3 (GND), HE9.3 (GND), HE10.3 (GND), HE11.3 (GND), HE12.3 (GND), HE13.3 (GND), HE14.3 (GND), HE15.3 (GND), HE16.3 (GND), HE17.3 (GND), HE18.3 (GND), HE19.3 (GND), HE20.3 (GND), HE21.3 (GND), HE22.3 (GND), HE23.3 (GND), HE24.3 (GND), HE25.3 (GND), HE26.3 (GND), HE27.3 (GND), HE28.3 (GND), HE29.3 (GND), HE30.3 (GND), HE31.3 (GND), HE32.3 (GND), HE33.3 (GND), HE34.3 (GND), HE35.3 (GND), HE36.3 (GND), HE37.3 (GND), HE38.3 (GND), HE39.3 (GND), HE40.3 (GND), HE41.3 (GND), HE42.3 (GND), HE43.3 (GND), HE44.3 (GND), HE45.3 (GND), HE46.3 (GND), HE47.3 (GND), HE48.3 (GND), HE49.3 (GND), HE50.3 (GND), HE51.3 (GND), HE52.3 (GND), HE53.3 (GND), HE54.3 (GND), HE55.3 (GND), HE56.3 (GND), HE57.3 (GND), HE58.3 (GND), HE59.3 (GND), HE60.3 (GND), HE61.3 (GND), HE62.3 (GND), HE63.3 (GND), HE64.3 (GND), HE65.3 (GND), HE66.3 (GND), HE67.3 (GND), HE68.3 (GND), U6.12 (GND), U6.15 (~E), U7.12 (GND), U7.15 (~E), U8.4 (I5), U8.7 (I2), U8.9 (I0), U8.12 (GND), U8.15 (~E), U8.17 (I14), U8.18 (I13), U8.20 (I11), U8.21 (I10), U9.4 (I5), U9.6 (I3), U9.7 (I2), U9.9 (I0), U9.12 (GND), U9.15 (~E), U9.22 (I9), U10.12 (GND), U10.15 (~E); also elsewhere on the board
