Charading/SM65/pcbs/SM65.kicad_pcb

## KiCad design pcbs/SM65.kicad_pcb (continued)

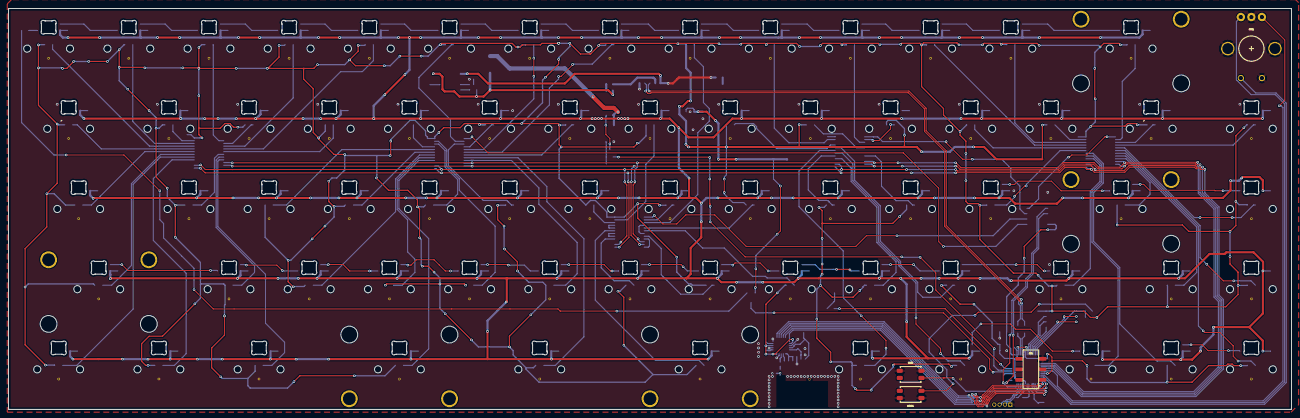
[picture p5: board SM65.kicad_pcb from above]

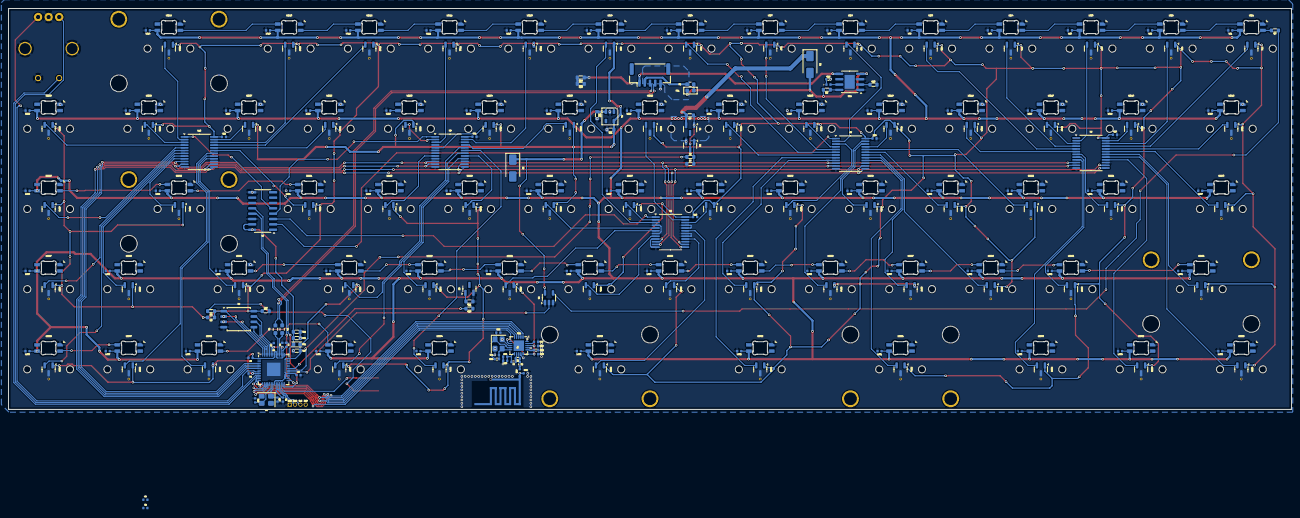
[picture p6: board SM65.kicad_pcb from below]

Board: 2 copper layers, 304.8 x 95.3 mm, 285 parts (281 on the bottom side), 207 nets.
