Charading/SM65/testing/hall_matrix/hall_matrix.kicad_pcb

## KiCad design testing/hall_matrix/hall_matrix.kicad_pcb (2025-11-08)

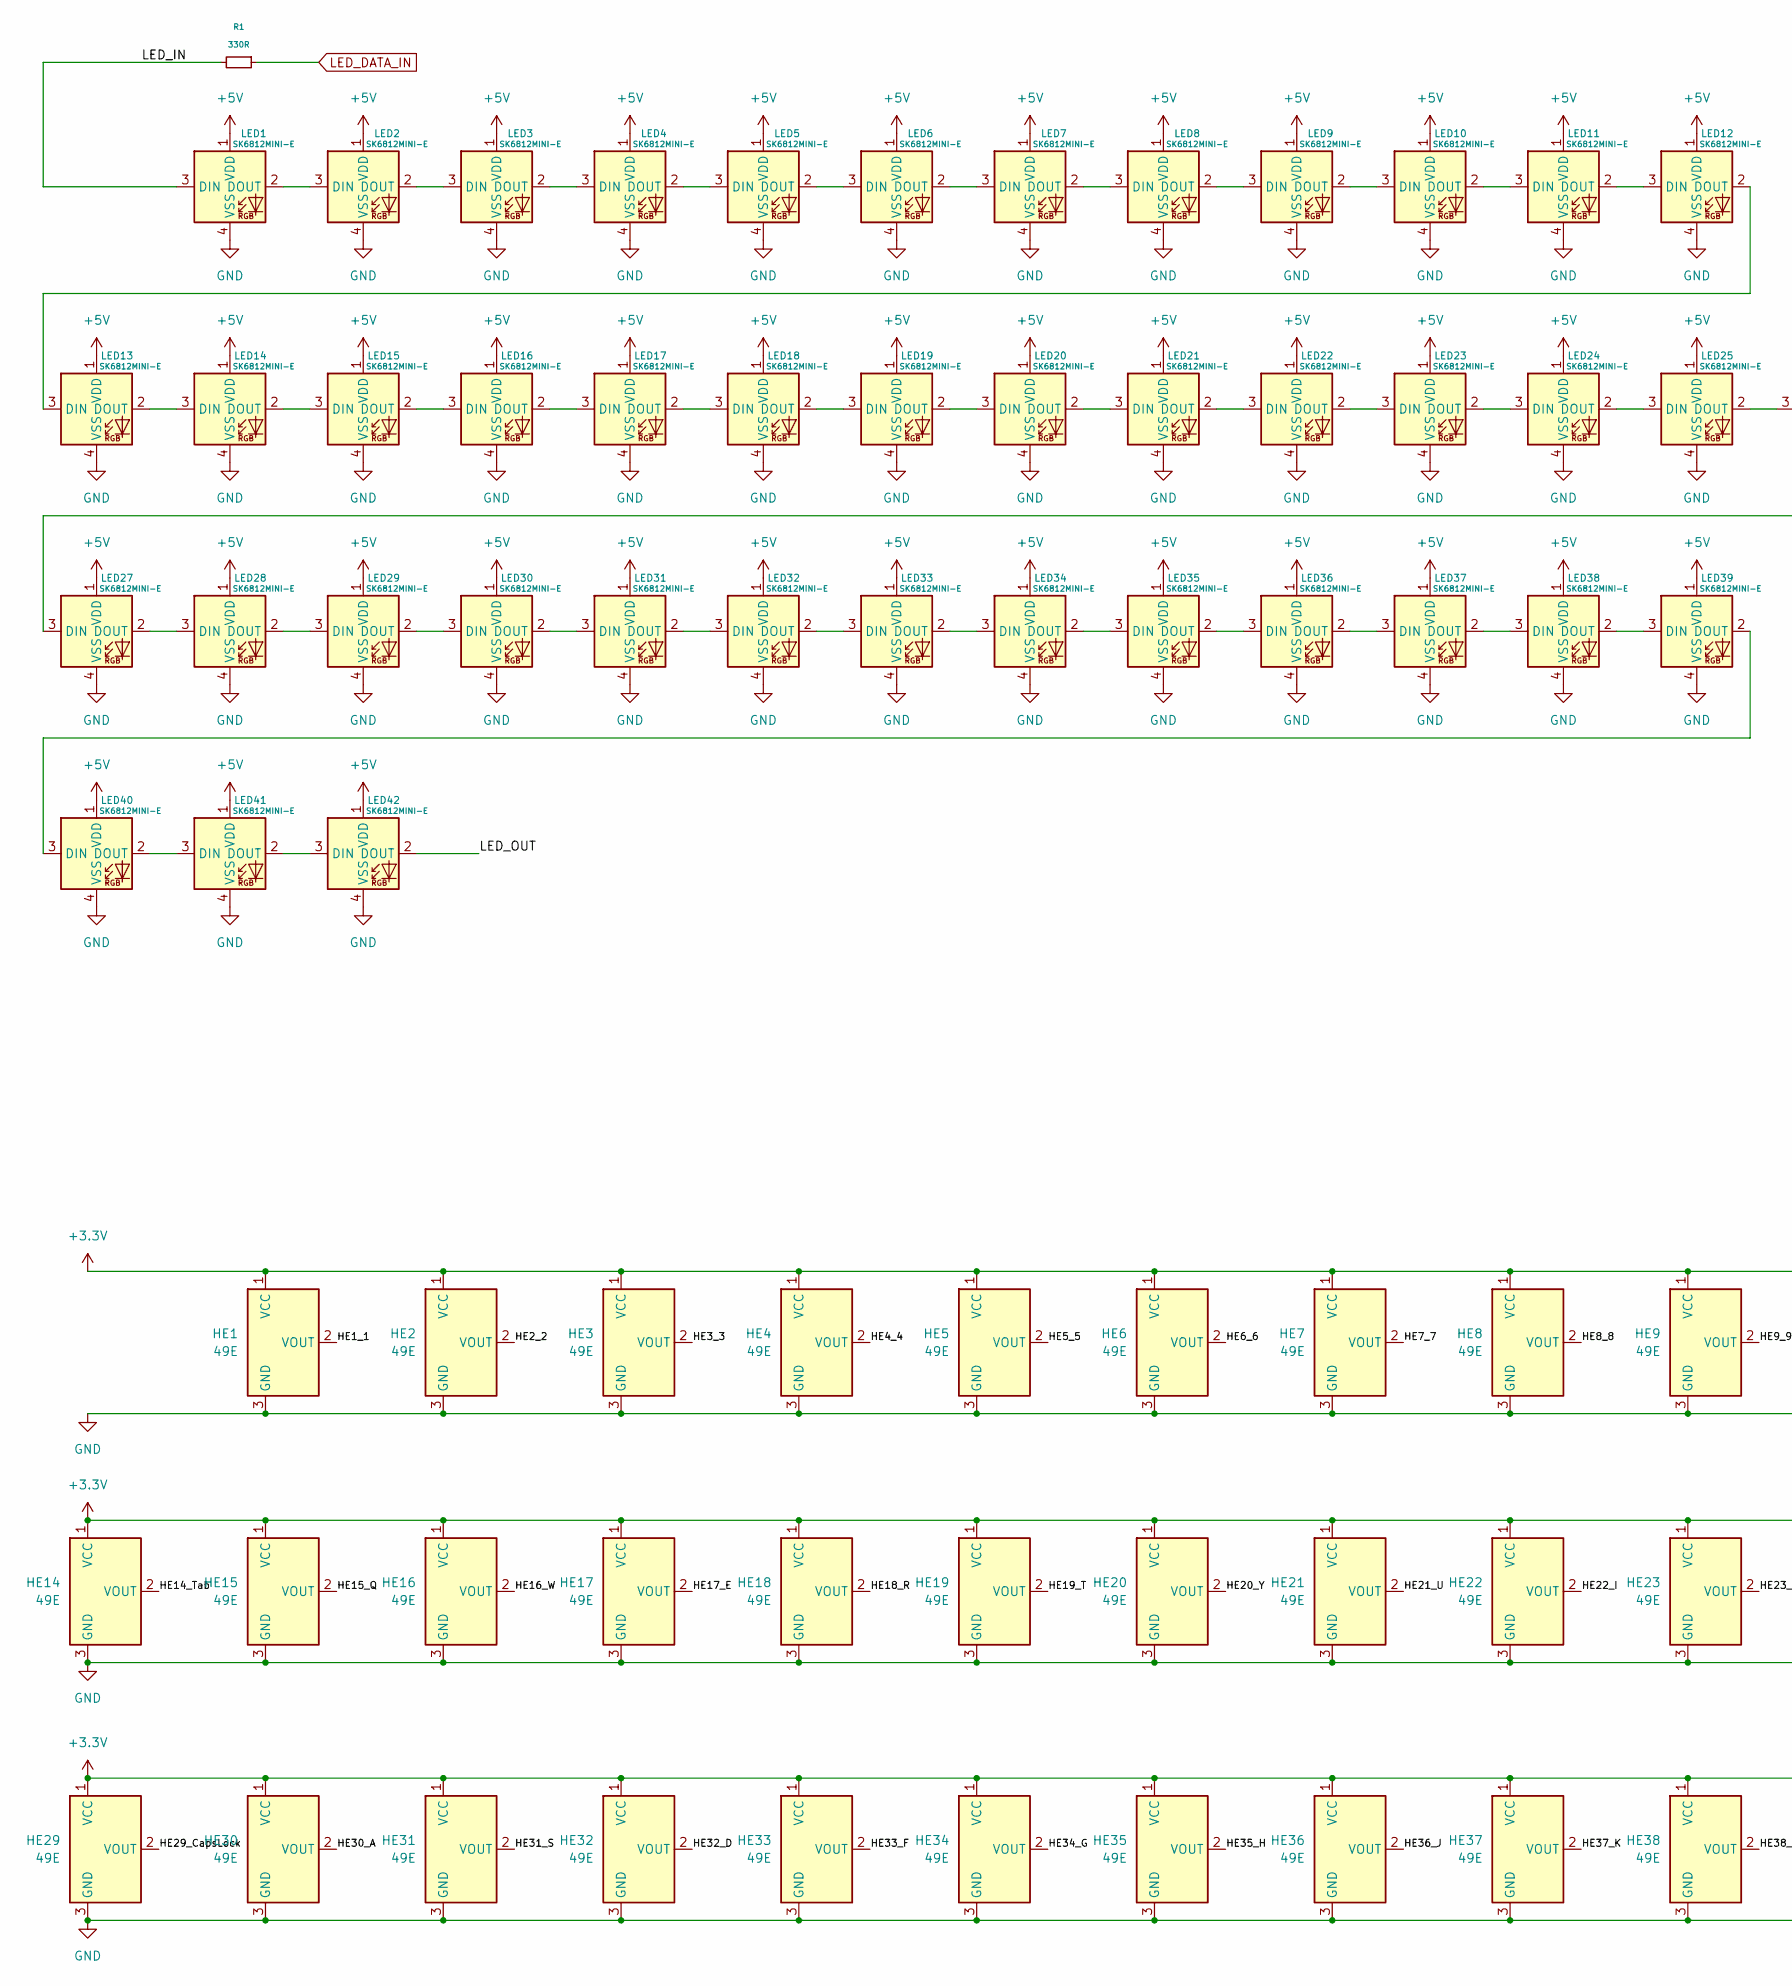
[picture p7: schematic hall_matrix.kicad_sch, part in row 1, column 1]

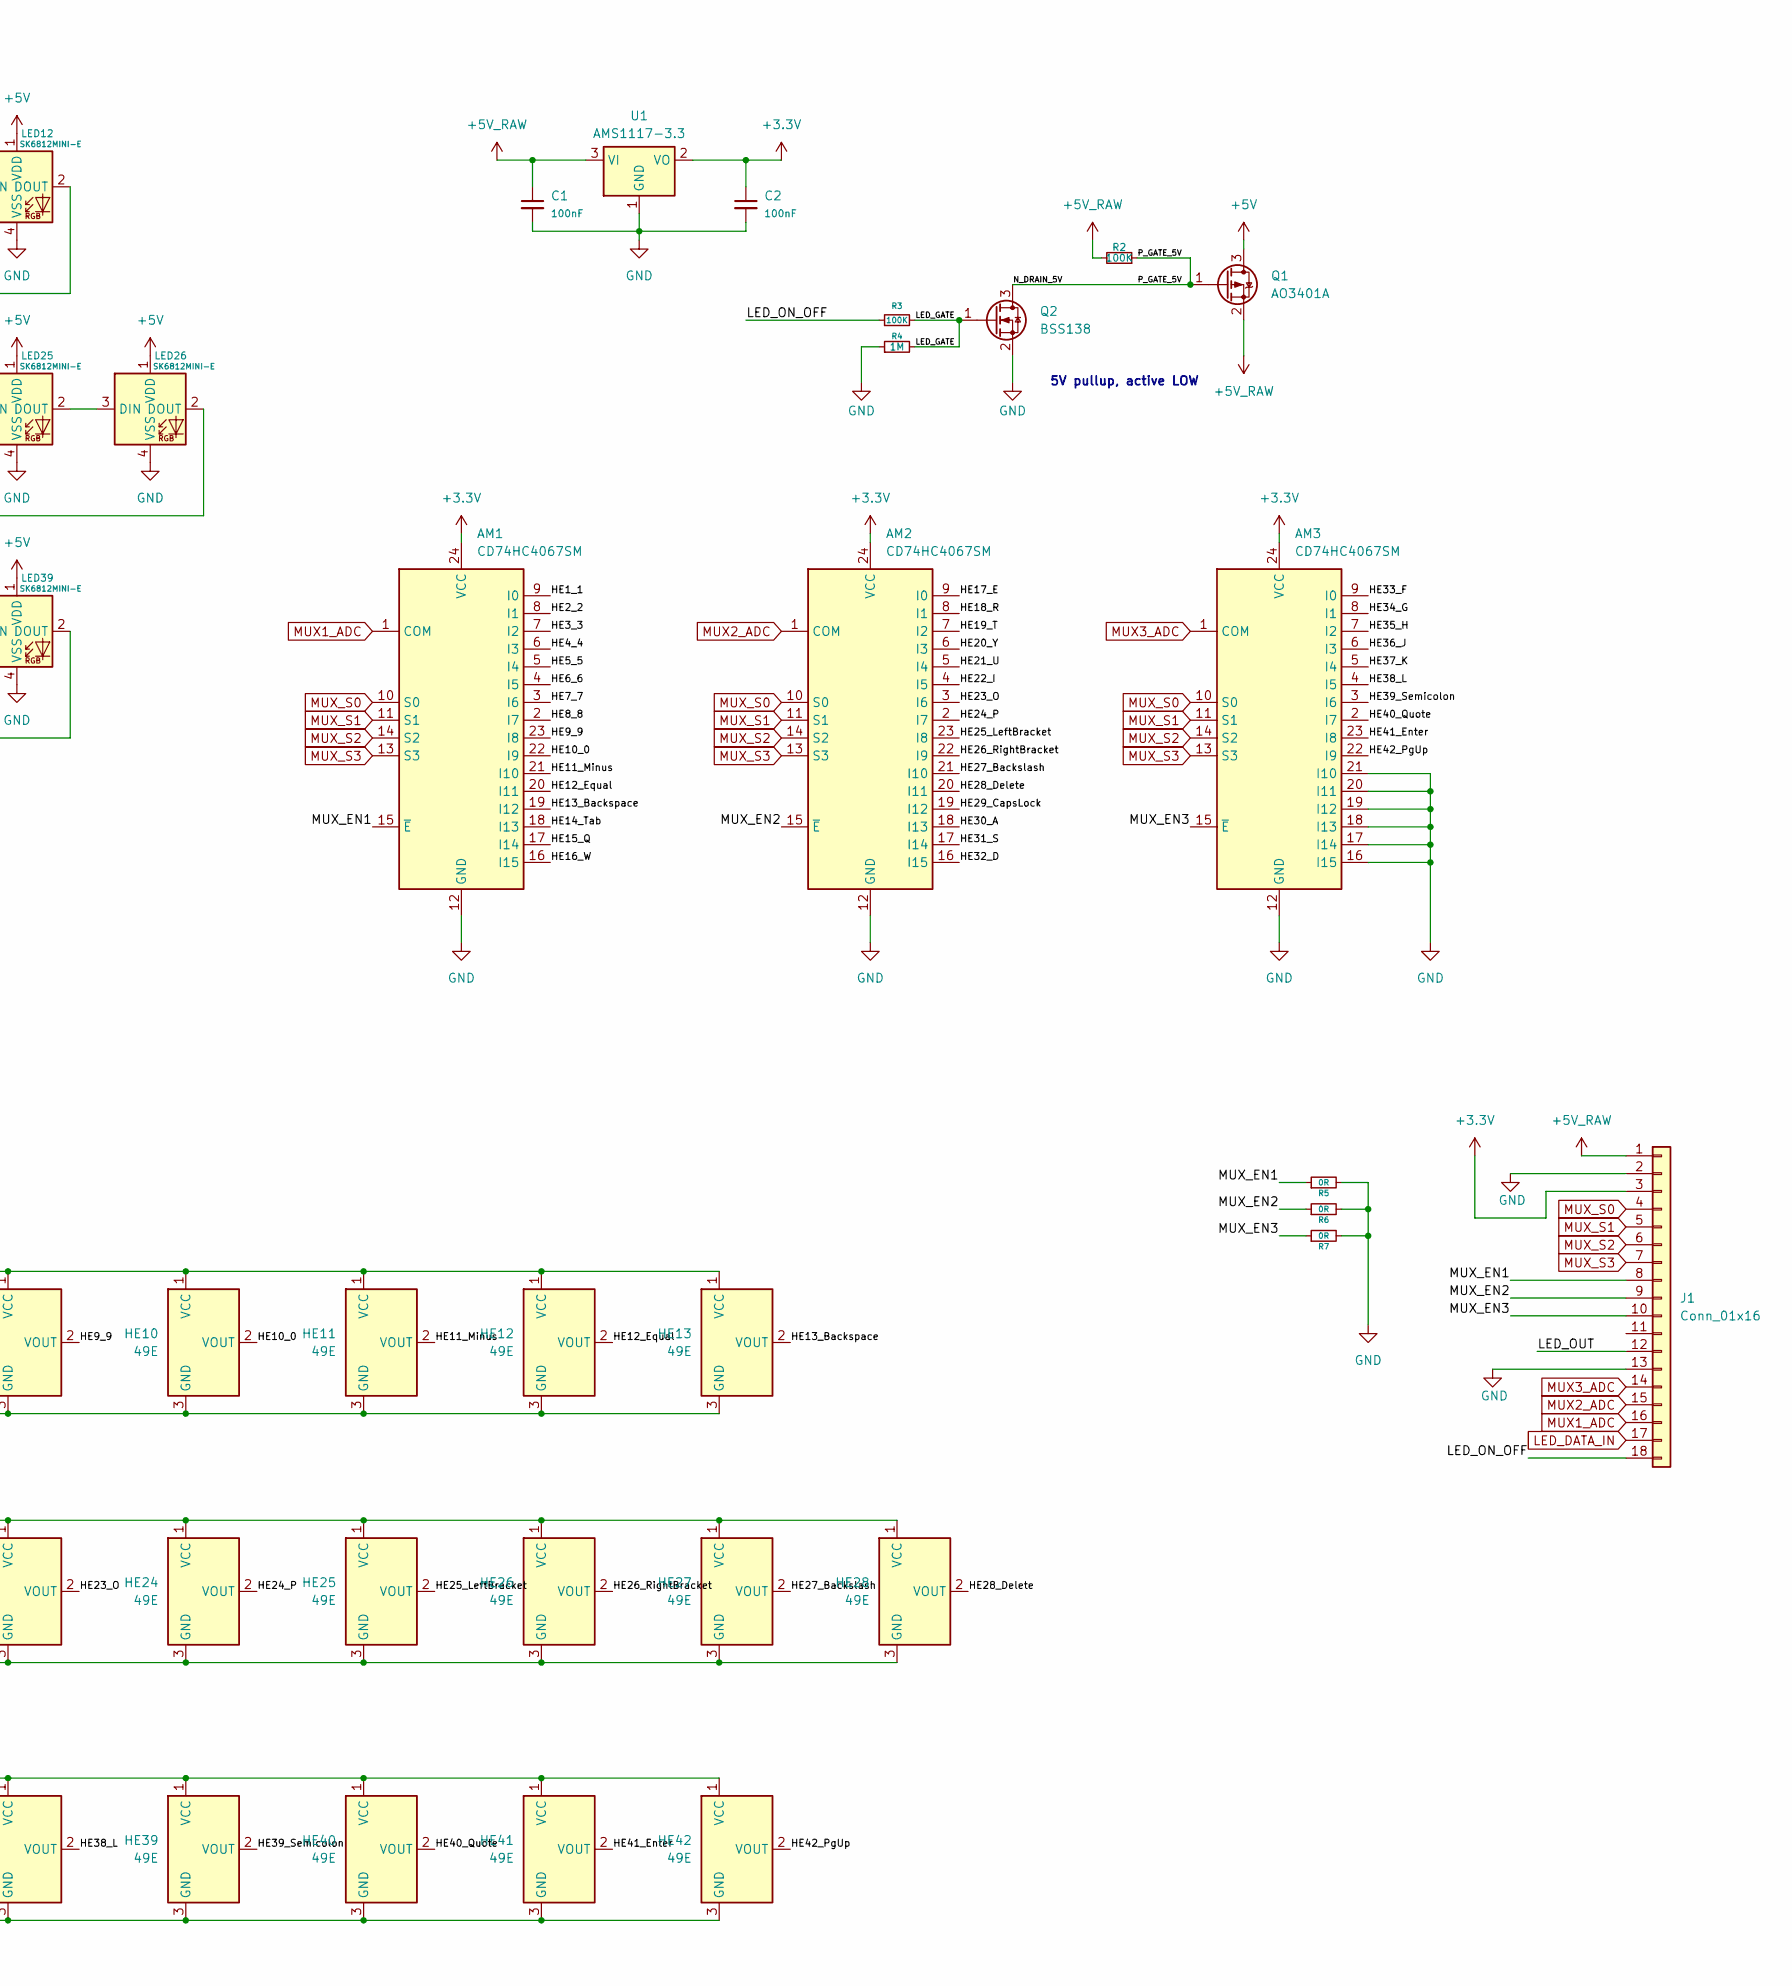
[picture p8: schematic hall_matrix.kicad_sch, part in row 1, column 2]

Parts:
AM1, AM2, AM3: CD74HC4067SM; SSOP-24_5.3x8.2mm_P0.65mm
C1, C2: 100nF; C_0603
HE1, HE2, HE3, HE4, HE5, HE6, HE7, HE8, HE9, HE10, HE11, HE12, HE13, HE14, HE15, HE16, HE17, HE18, HE19, HE20, HE21, HE22, HE23, HE24, HE25, HE26, HE27, HE28, HE29, HE30, HE31, HE32, HE33, HE34, HE35, HE36, HE37, HE38, HE39, HE40, HE41, HE42: 49E; SW_MX_HE_90deg_1u_4layer; LCSC C7420984
J1: Conn_01x16; PinHeader_1x18_P2.54mm_Vertical
LED1, LED2, LED3, LED4, LED5, LED6, LED7, LED8, LED9, LED10, LED11, LED12, LED13, LED14, LED15, LED16, LED17, LED18, LED19, LED20, LED21, LED22, LED23, LED24, LED25, LED26, LED27, LED28, LED29, LED30, LED31, LED32, LED33, LED34, LED35, LED36, LED37, LED38, LED39, LED40, LED41, LED42: SK6812MINI-E; LED_6028R; LCSC C5149201
Q1: AO3401A; SOT-23
Q2: BSS138; SOT-23
R1: 330R; R_0603
R2, R3: 100K; R_0603
R4: 1M; R_0603
R5, R6, R7: 0R; R_0603
U1: AMS1117-3.3; SOT-223-3_TabPin2

Connections:
+3.3V: AM1.24 (VCC), AM2.24 (VCC), AM3.24 (VCC), C2.1, HE1.1 (VCC), HE2.1 (VCC), HE3.1 (VCC), HE4.1 (VCC), HE5.1 (VCC), HE6.1 (VCC), HE7.1 (VCC), HE8.1 (VCC), HE9.1 (VCC), HE10.1 (VCC), HE11.1 (VCC), HE12.1 (VCC), HE13.1 (VCC), HE14.1 (VCC), HE15.1 (VCC), HE16.1 (VCC), HE17.1 (VCC), HE18.1 (VCC), HE19.1 (VCC), HE20.1 (VCC), HE21.1 (VCC), HE22.1 (VCC), HE23.1 (VCC), HE24.1 (VCC), HE25.1 (VCC), HE26.1 (VCC), HE27.1 (VCC), HE28.1 (VCC), HE29.1 (VCC), HE30.1 (VCC), HE31.1 (VCC), HE32.1 (VCC), HE33.1 (VCC), HE34.1 (VCC), HE35.1 (VCC), HE36.1 (VCC), HE37.1 (VCC), HE38.1 (VCC), HE39.1 (VCC), HE40.1 (VCC), HE41.1 (VCC), HE42.1 (VCC), J1.3, U1.2 (VO)
+5V: LED1.1 (VDD), LED2.1 (VDD), LED3.1 (VDD), LED4.1 (VDD), LED5.1 (VDD), LED6.1 (VDD), LED7.1 (VDD), LED8.1 (VDD), LED9.1 (VDD), LED10.1 (VDD), LED11.1 (VDD), LED12.1 (VDD), LED13.1 (VDD), LED14.1 (VDD), LED15.1 (VDD), LED16.1 (VDD), LED17.1 (VDD), LED18.1 (VDD), LED19.1 (VDD), LED20.1 (VDD), LED21.1 (VDD), LED22.1 (VDD), LED23.1 (VDD), LED24.1 (VDD), LED25.1 (VDD), LED26.1 (VDD), LED27.1 (VDD), LED28.1 (VDD), LED29.1 (VDD), LED30.1 (VDD), LED31.1 (VDD), LED32.1 (VDD), LED33.1 (VDD), LED34.1 (VDD), LED35.1 (VDD), LED36.1 (VDD), LED37.1 (VDD), LED38.1 (VDD), LED39.1 (VDD), LED40.1 (VDD), LED41.1 (VDD), LED42.1 (VDD), Q1.3 (D)
+5V_RAW: C1.1, J1.1, Q1.2 (S), R2.2, U1.3 (VI)
/HE1_1: AM1.9 (I0), HE1.2 (VOUT)
/HE2_2: AM1.8 (I1), HE2.2 (VOUT)
/HE3_3: AM1.7 (I2), HE3.2 (VOUT)
/HE4_4: AM1.6 (I3), HE4.2 (VOUT)
/HE5_5: AM1.5 (I4), HE5.2 (VOUT)
/HE6_6: AM1.4 (I5), HE6.2 (VOUT)
/HE7_7: AM1.3 (I6), HE7.2 (VOUT)
/HE8_8: AM1.2 (I7), HE8.2 (VOUT)
/HE9_9: AM1.23 (I8), HE9.2 (VOUT)
/HE10_0: AM1.22 (I9), HE10.2 (VOUT)
/HE11_Minus: AM1.21 (I10), HE11.2 (VOUT)
/HE12_Equal: AM1.20 (I11), HE12.2 (VOUT)
/HE13_Backspace: AM1.19 (I12), HE13.2 (VOUT)
/HE14_Tab: AM1.18 (I13), HE14.2 (VOUT)
/HE15_Q: AM1.17 (I14), HE15.2 (VOUT)
/HE16_W: AM1.16 (I15), HE16.2 (VOUT)
/HE17_E: AM2.9 (I0), HE17.2 (VOUT)
/HE18_R: AM2.8 (I1), HE18.2 (VOUT)
/HE19_T: AM2.7 (I2), HE19.2 (VOUT)
/HE20_Y: AM2.6 (I3), HE20.2 (VOUT)
/HE21_U: AM2.5 (I4), HE21.2 (VOUT)
/HE22_I: AM2.4 (I5), HE22.2 (VOUT)
/HE23_O: AM2.3 (I6), HE23.2 (VOUT)
/HE24_P: AM2.2 (I7), HE24.2 (VOUT)
/HE25_LeftBracket: AM2.23 (I8), HE25.2 (VOUT)
/HE26_RightBracket: AM2.22 (I9), HE26.2 (VOUT)
/HE27_Backslash: AM2.21 (I10), HE27.2 (VOUT)
/HE28_Delete: AM2.20 (I11), HE28.2 (VOUT)
/HE29_CapsLock: AM2.19 (I12), HE29.2 (VOUT)
/HE30_A: AM2.18 (I13), HE30.2 (VOUT)
/HE31_S: AM2.17 (I14), HE31.2 (VOUT)
/HE32_D: AM2.16 (I15), HE32.2 (VOUT)
/HE33_F: AM3.9 (I0), HE33.2 (VOUT)
/HE34_G: AM3.8 (I1), HE34.2 (VOUT)
/HE35_H: AM3.7 (I2), HE35.2 (VOUT)
/HE36_J: AM3.6 (I3), HE36.2 (VOUT)
/HE37_K: AM3.5 (I4), HE37.2 (VOUT)
/HE38_L: AM3.4 (I5), HE38.2 (VOUT)
/HE39_Semicolon: AM3.3 (I6), HE39.2 (VOUT)
/HE40_Quote: AM3.2 (I7), HE40.2 (VOUT)
/HE41_Enter: AM3.23 (I8), HE41.2 (VOUT)
/HE42_PgUp: AM3.22 (I9), HE42.2 (VOUT)
/LED_GATE: Q2.1 (G), R3.2, R4.2
/LED_IN: LED1.3 (DIN), R1.2
/LED_ON_OFF: J1.18, R3.1
/LED_OUT: J1.12, LED42.2 (DOUT)
/MUX_EN1: AM1.15 (~E), J1.8, R5.1
/MUX_EN2: AM2.15 (~E), J1.9, R6.1
/MUX_EN3: AM3.15 (~E), J1.10, R7.1
/N_DRAIN_5V: Q1.1 (G), Q2.3 (D), R2.1
GND: AM1.12 (GND), AM2.12 (GND), AM3.12 (GND), AM3.16 (I15), AM3.17 (I14), AM3.18 (I13), AM3.19 (I12), AM3.20 (I11), AM3.21 (I10), C1.2, C2.2, HE1.3 (GND), HE2.3 (GND), HE3.3 (GND), HE4.3 (GND), HE5.3 (GND), HE6.3 (GND), HE7.3 (GND), HE8.3 (GND), HE9.3 (GND), HE10.3 (GND), HE11.3 (GND), HE12.3 (GND), HE13.3 (GND), HE14.3 (GND), HE15.3 (GND), HE16.3 (GND), HE17.3 (GND), HE18.3 (GND), HE19.3 (GND), HE20.3 (GND), HE21.3 (GND), HE22.3 (GND), HE23.3 (GND), HE24.3 (GND), HE25.3 (GND), HE26.3 (GND), HE27.3 (GND), HE28.3 (GND), HE29.3 (GND), HE30.3 (GND), HE31.3 (GND), HE32.3 (GND), HE33.3 (GND), HE34.3 (GND), HE35.3 (GND), HE36.3 (GND), HE37.3 (GND), HE38.3 (GND), HE39.3 (GND), HE40.3 (GND), HE41.3 (GND), HE42.3 (GND), J1.2, J1.13, LED1.4 (VSS), LED2.4 (VSS), LED3.4 (VSS), LED4.4 (VSS), LED5.4 (VSS), LED6.4 (VSS), LED7.4 (VSS), LED8.4 (VSS), LED9.4 (VSS), LED10.4 (VSS), LED11.4 (VSS), LED12.4 (VSS), LED13.4 (VSS), LED14.4 (VSS), LED15.4 (VSS), LED16.4 (VSS), LED17.4 (VSS), LED18.4 (VSS), LED19.4 (VSS), LED20.4 (VSS), LED21.4 (VSS), LED22.4 (VSS), LED23.4 (VSS), LED24.4 (VSS), LED25.4 (VSS), LED26.4 (VSS), LED27.4 (VSS), LED28.4 (VSS), LED29.4 (VSS), LED30.4 (VSS), LED31.4 (VSS), LED32.4 (VSS), LED33.4 (VSS), LED34.4 (VSS), LED35.4 (VSS), LED36.4 (VSS), LED37.4 (VSS), LED38.4 (VSS), LED39.4 (VSS), LED40.4 (VSS), LED41.4 (VSS), LED42.4 (VSS), Q2.2 (S), R4.1, R5.2, R6.2, R7.2, U1.1 (GND)
LED_DATA_IN: J1.17, R1.1
MUX1_ADC: AM1.1 (COM), J1.16
MUX2_ADC: AM2.1 (COM), J1.15
MUX3_ADC: AM3.1 (COM), J1.14
MUX_S0: AM1.10 (S0), AM2.10 (S0), AM3.10 (S0), J1.4
MUX_S1: AM1.11 (S1), AM2.11 (S1), AM3.11 (S1), J1.5
MUX_S2: AM1.14 (S2), AM2.14 (S2), AM3.14 (S2), J1.6
MUX_S3: AM1.13 (S3), AM2.13 (S3), AM3.13 (S3), J1.7
unnamed: LED1.2 (DOUT), LED2.3 (DIN)
unnamed: LED2.2 (DOUT), LED3.3 (DIN)
unnamed: LED3.2 (DOUT), LED4.3 (DIN)
unnamed: LED4.2 (DOUT), LED5.3 (DIN)
unnamed: LED5.2 (DOUT), LED6.3 (DIN)
unnamed: LED6.2 (DOUT), LED7.3 (DIN)
unnamed: LED7.2 (DOUT), LED8.3 (DIN)
unnamed: LED8.2 (DOUT), LED9.3 (DIN)
unnamed: LED9.2 (DOUT), LED10.3 (DIN)
unnamed: LED10.2 (DOUT), LED11.3 (DIN)
unnamed: LED11.2 (DOUT), LED12.3 (DIN)
unnamed: LED12.2 (DOUT), LED13.3 (DIN)
unnamed: LED13.2 (DOUT), LED14.3 (DIN)
unnamed: LED14.2 (DOUT), LED15.3 (DIN)
unnamed: LED15.2 (DOUT), LED16.3 (DIN)
unnamed: LED16.2 (DOUT), LED17.3 (DIN)
unnamed: LED17.2 (DOUT), LED18.3 (DIN)
unnamed: LED18.2 (DOUT), LED19.3 (DIN)
unnamed: LED19.2 (DOUT), LED20.3 (DIN)
unnamed: LED20.2 (DOUT), LED21.3 (DIN)
unnamed: LED21.2 (DOUT), LED22.3 (DIN)
unnamed: LED22.2 (DOUT), LED23.3 (DIN)
unnamed: LED23.2 (DOUT), LED24.3 (DIN)
unnamed: LED24.2 (DOUT), LED25.3 (DIN)
unnamed: LED25.2 (DOUT), LED26.3 (DIN)
unnamed: LED26.2 (DOUT), LED27.3 (DIN)
unnamed: LED27.2 (DOUT), LED28.3 (DIN)
unnamed: LED28.2 (DOUT), LED29.3 (DIN)
unnamed: LED29.2 (DOUT), LED30.3 (DIN)
unnamed: LED30.2 (DOUT), LED31.3 (DIN)
unnamed: LED31.2 (DOUT), LED32.3 (DIN)
unnamed: LED32.2 (DOUT), LED33.3 (DIN)
unnamed: LED33.2 (DOUT), LED34.3 (DIN)
unnamed: LED34.2 (DOUT), LED35.3 (DIN)
unnamed: LED35.2 (DOUT), LED36.3 (DIN)
unnamed: LED36.2 (DOUT), LED37.3 (DIN)
unnamed: LED37.2 (DOUT), LED38.3 (DIN)
unnamed: LED38.2 (DOUT), LED39.3 (DIN)
unnamed: LED39.2 (DOUT), LED40.3 (DIN)
unnamed: LED40.2 (DOUT), LED41.3 (DIN)
unnamed: LED41.2 (DOUT), LED42.3 (DIN)

Notes on the sheet:
5V pullup, active LOW

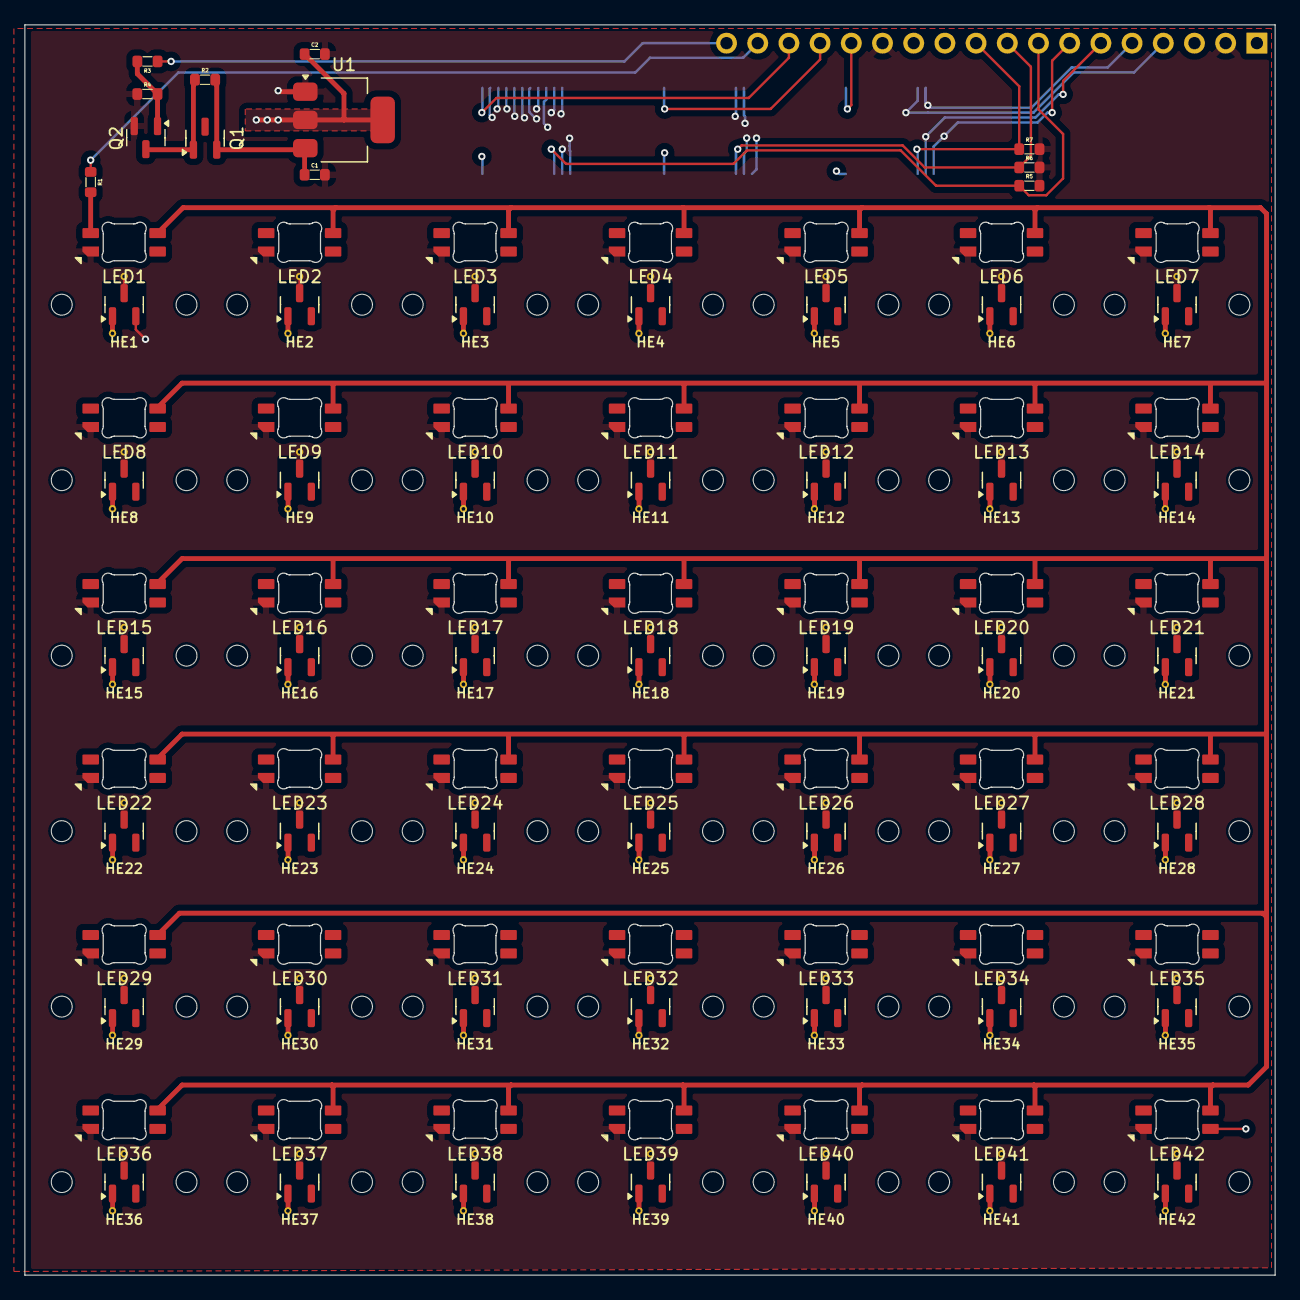
[picture p9: board hall_matrix.kicad_pcb from above]

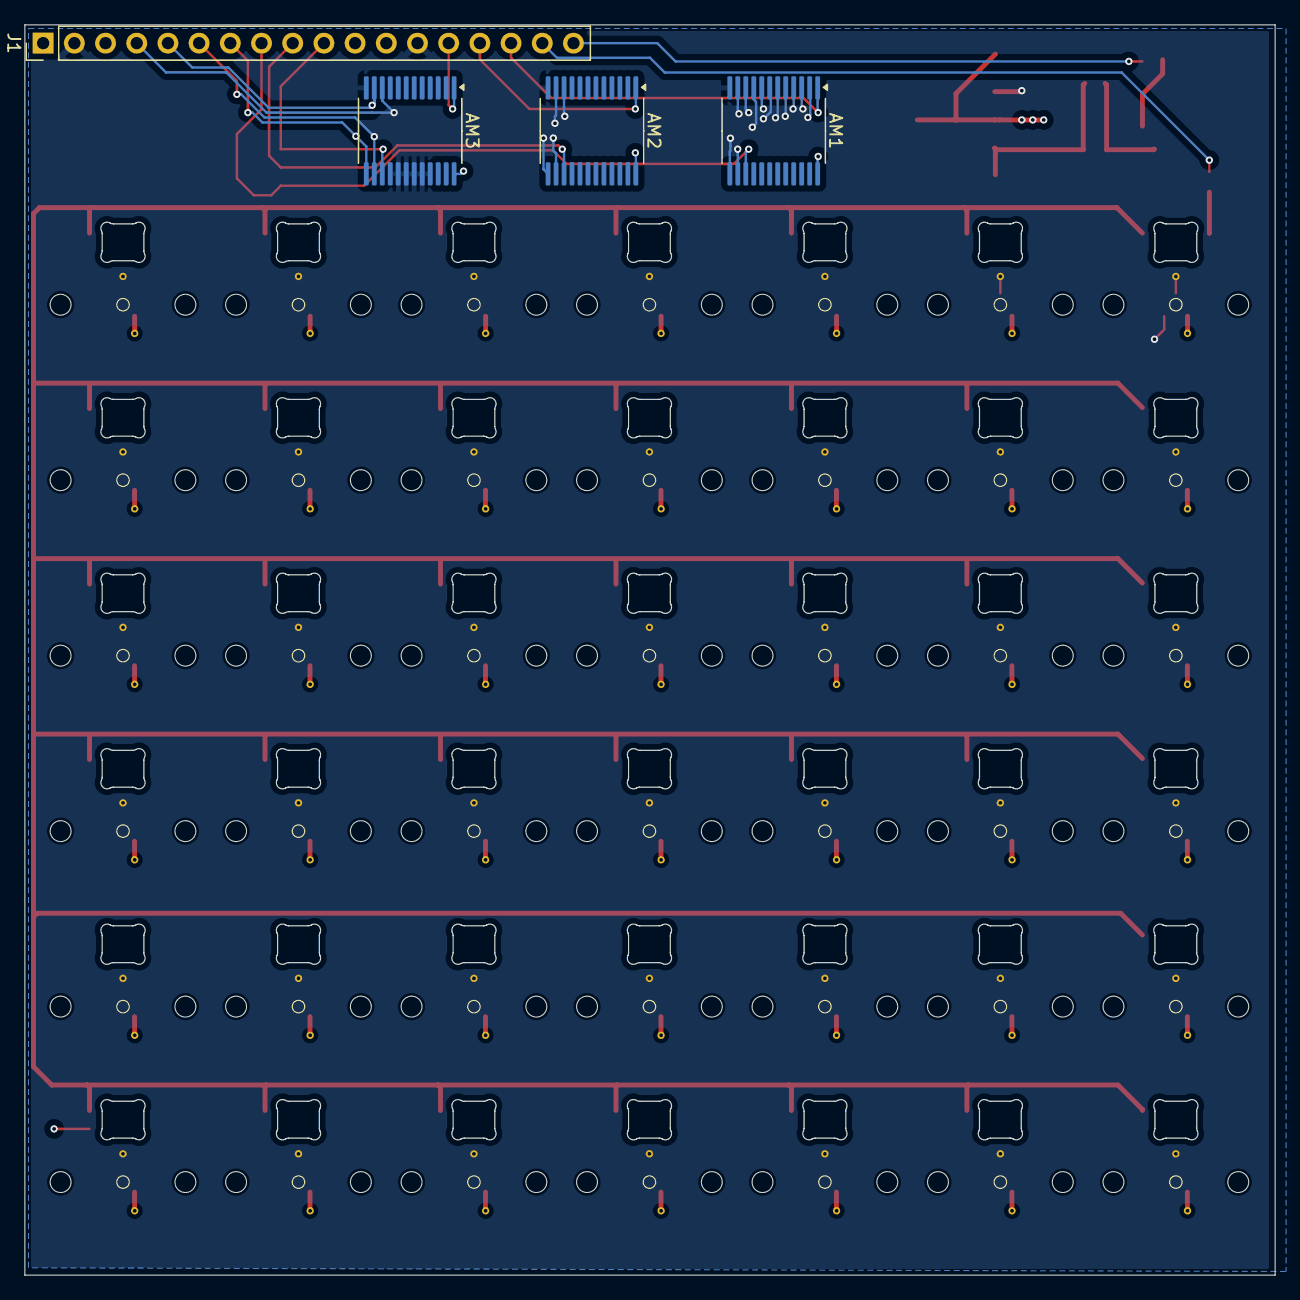
[picture p10: board hall_matrix.kicad_pcb from below]

Board: 4 copper layers, 101.8 x 101.8 mm, 100 parts (4 on the bottom side), 103 nets.
