Charading/SM65/testing/rp2350_c_hid/config.h

#define MUX_S0 10
#define MUX_S1 11
#define MUX_S2 12
#define MUX_S3 13

#define MUX1_PIN 40  // ADC0 (GP40)
#define MUX2_PIN 45  // ADC1 (GP41)
#define MUX3_PIN 46  // ADC2 (GP42)
#define MUX4_PIN 47  // ADC3 (GP43)
#define MUX5_PIN 44  // ADC4 (GP44) - RP2350B only
