Charading/SM65/testing/rp2350_firmware_testing/tusb_config.h

#ifndef _TUSB_CONFIG_H_
#define _TUSB_CONFIG_H_

#ifdef __cplusplus
extern "C" {
#endif

//--------------------------------------------------------------------
// Board Specific Configuration
//--------------------------------------------------------------------

// RHPort number used for device
#ifndef BOARD_TUD_RHPORT
#define BOARD_TUD_RHPORT      0
#endif

// RHPort max operational speed
#ifndef BOARD_TUD_MAX_SPEED
#define BOARD_TUD_MAX_SPEED   OPT_MODE_DEFAULT_SPEED
#endif

//--------------------------------------------------------------------
// COMMON CONFIGURATION
//--------------------------------------------------------------------

#ifndef CFG_TUSB_MCU
#define CFG_TUSB_MCU OPT_MCU_RP2040
#endif

#ifndef CFG_TUSB_OS
#define CFG_TUSB_OS OPT_OS_NONE
#endif

#ifndef CFG_TUSB_DEBUG
#define CFG_TUSB_DEBUG 0
#endif

// Enable device stack
#define CFG_TUD_ENABLED 1

// RHPort configuration (required by TinyUSB)
#define CFG_TUSB_RHPORT0_MODE (OPT_MODE_DEVICE | OPT_MODE_FULL_SPEED)

//--------------------------------------------------------------------
// DEVICE CONFIGURATION
//--------------------------------------------------------------------

#ifndef CFG_TUD_ENDPOINT0_SIZE
#define CFG_TUD_ENDPOINT0_SIZE 64
#endif

// Device class drivers
#define CFG_TUD_HID             1
#define CFG_TUD_CDC             1
#define CFG_TUD_MSC             0
#define CFG_TUD_MIDI            0
#define CFG_TUD_VENDOR          0
#define CFG_TUD_AUDIO           0
#define CFG_TUD_VIDEO           0
#define CFG_TUD_DFU_RUNTIME     0
#define CFG_TUD_ECM_RNDIS       0
#define CFG_TUD_NCM             0
#define CFG_TUD_BTH             0

// HID buffer size
#define CFG_TUD_HID_EP_BUFSIZE 16

// CDC FIFO size
#define CFG_TUD_CDC_RX_BUFSIZE 256
#define CFG_TUD_CDC_TX_BUFSIZE 256

#ifdef __cplusplus
}
#endif

#endif /* _TUSB_CONFIG_H_ */
