Charading/SM65/(commit log)

2025-11-08 was testing rp2350 with hc4067
    [SM65.kicad_pcb, SM65.kicad_sch, freerouting.dsn, hall_matrix.kicad_pcb, hall_matrix.kicad_sch, lighting.kicad_sch, sensors.kicad_sch, temp-freerouting.dsn]
2025-11-09 usb enumerated, cdc working to print adc voltages
    [SM65.kicad_sch]
2025-11-10 experimenting with MCP3208 and 4+ HC4067's
    [sensors.kicad_sch]
2025-11-24 improved schematic
    [SM65.kicad_sch, lighting.kicad_sch, sensors.kicad_sch]
2025-11-28 pcb updated
    [SM65.kicad_pcb, SM65.kicad_sch, lighting.kicad_sch, sensors.kicad_sch]
